Bojtronic/TFG/imagenes/PINOUT.jpeg

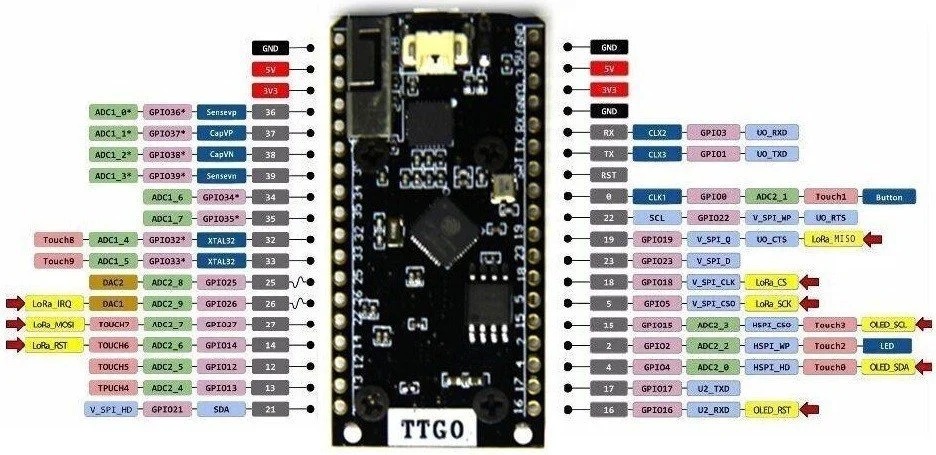
imagenes/PINOUT.jpeg
