Bojtronic/TFG/imagenes/fuego y leña.png

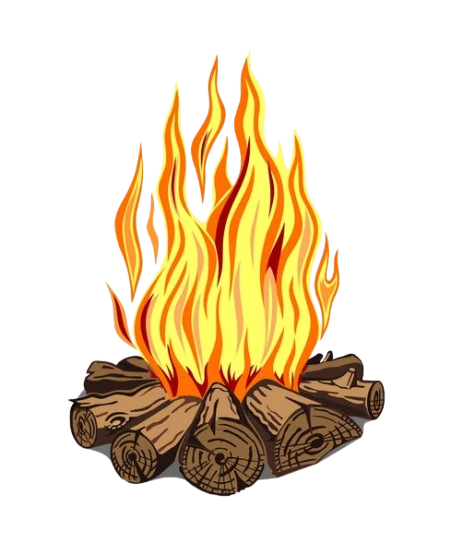
imagenes/fuego y leña.png
