Bojtronic/TFG/imagenes/Aplicacion web.PNG

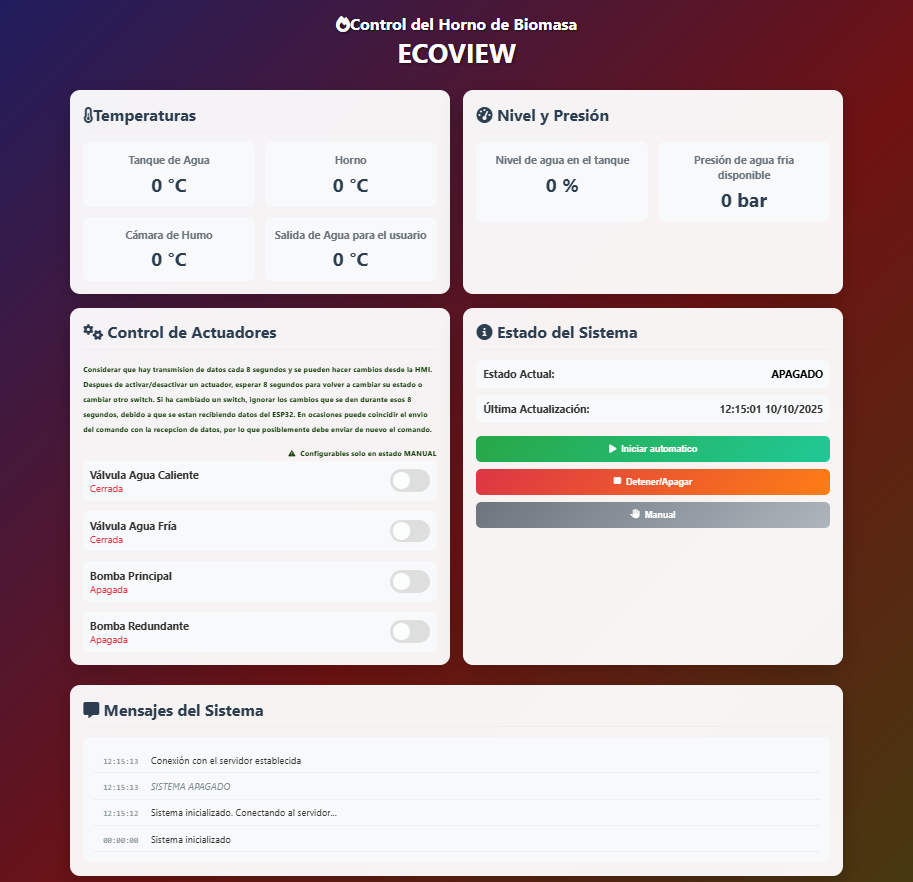
imagenes/Aplicacion web.PNG
