Bojtronic/TFG/imagenes/Bomba de agua.jpg

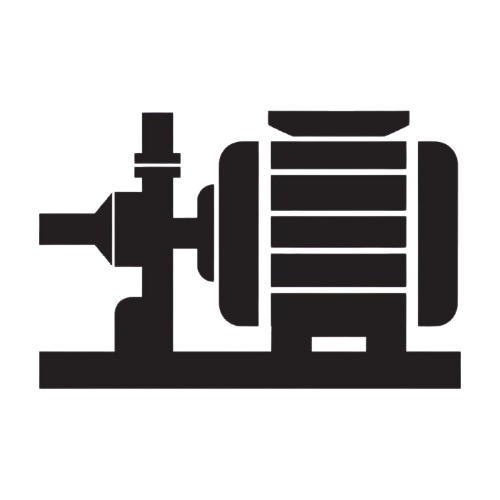
imagenes/Bomba de agua.jpg
