Bojtronic/TFG/imagenes/Canal de señal analogica.PNG

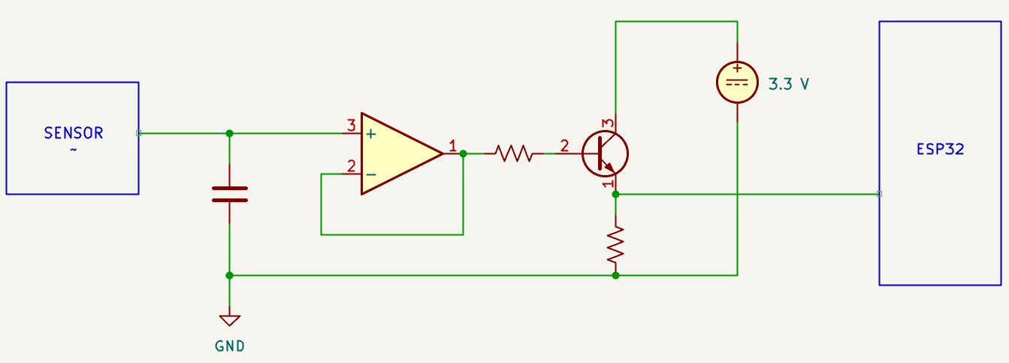
imagenes/Canal de señal analogica.PNG
