Bojtronic/TFG/imagenes/Circuito basico termocupla.PNG

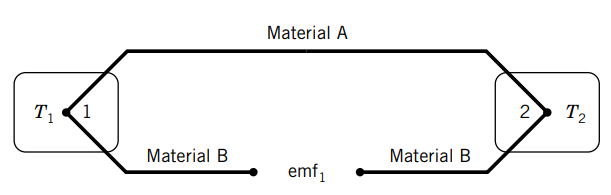
imagenes/Circuito basico termocupla.PNG
