Bojtronic/TFG/imagenes/circulacion de agua.png

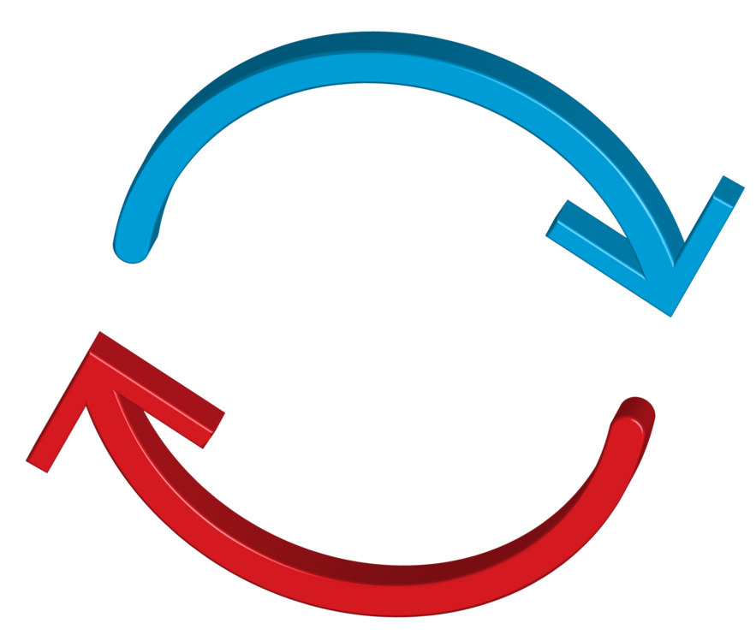
imagenes/circulacion de agua.png
