Bojtronic/TFG/imagenes/Compuerta de chimenea.png

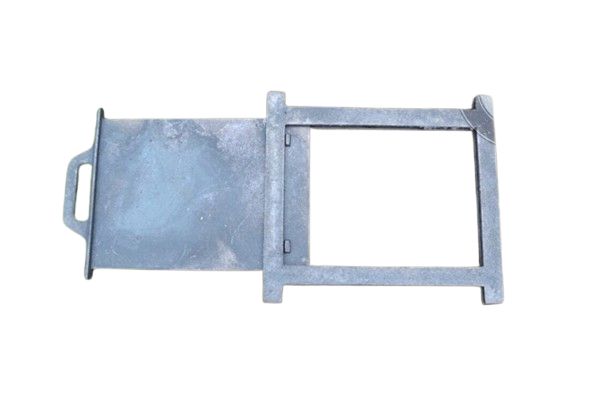
imagenes/Compuerta de chimenea.png
