Bojtronic/TFG/imagenes/Cronograma.PNG

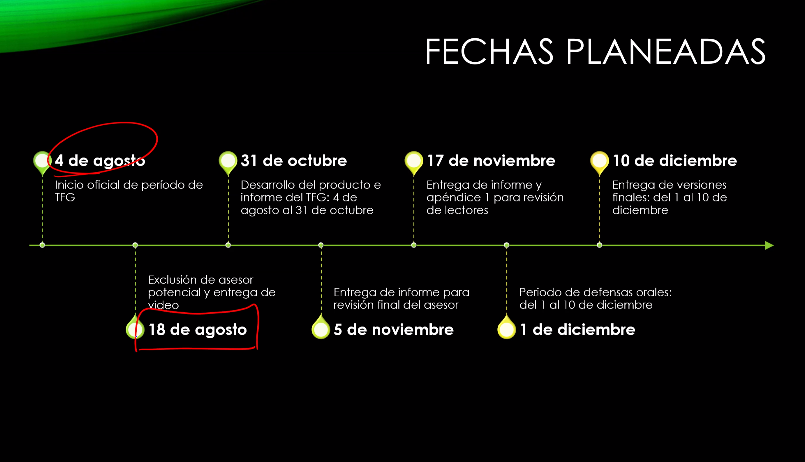
imagenes/Cronograma.PNG
