Bojtronic/TFG/imagenes/Datos importantes.PNG

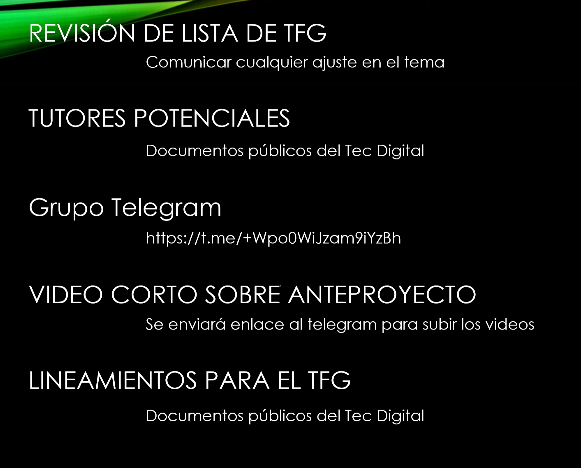
imagenes/Datos importantes.PNG
