Bojtronic/TFG/imagenes/Diagrama del sistema Horno-EcoView organizado.png

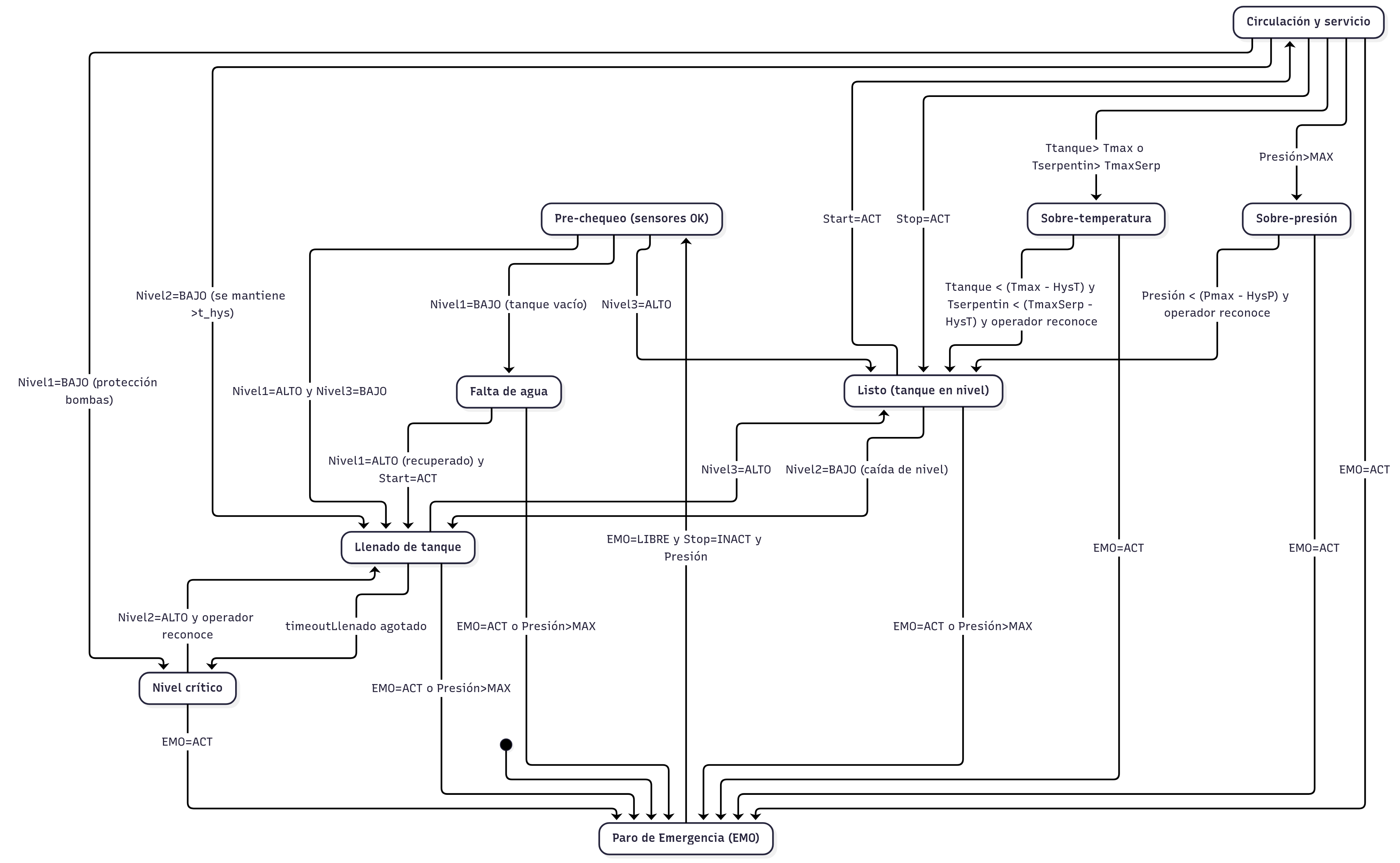
imagenes/Diagrama del sistema Horno-EcoView organizado.png
