Bojtronic/TFG/imagenes/Diagrama del sistema Horno-EcoView.png

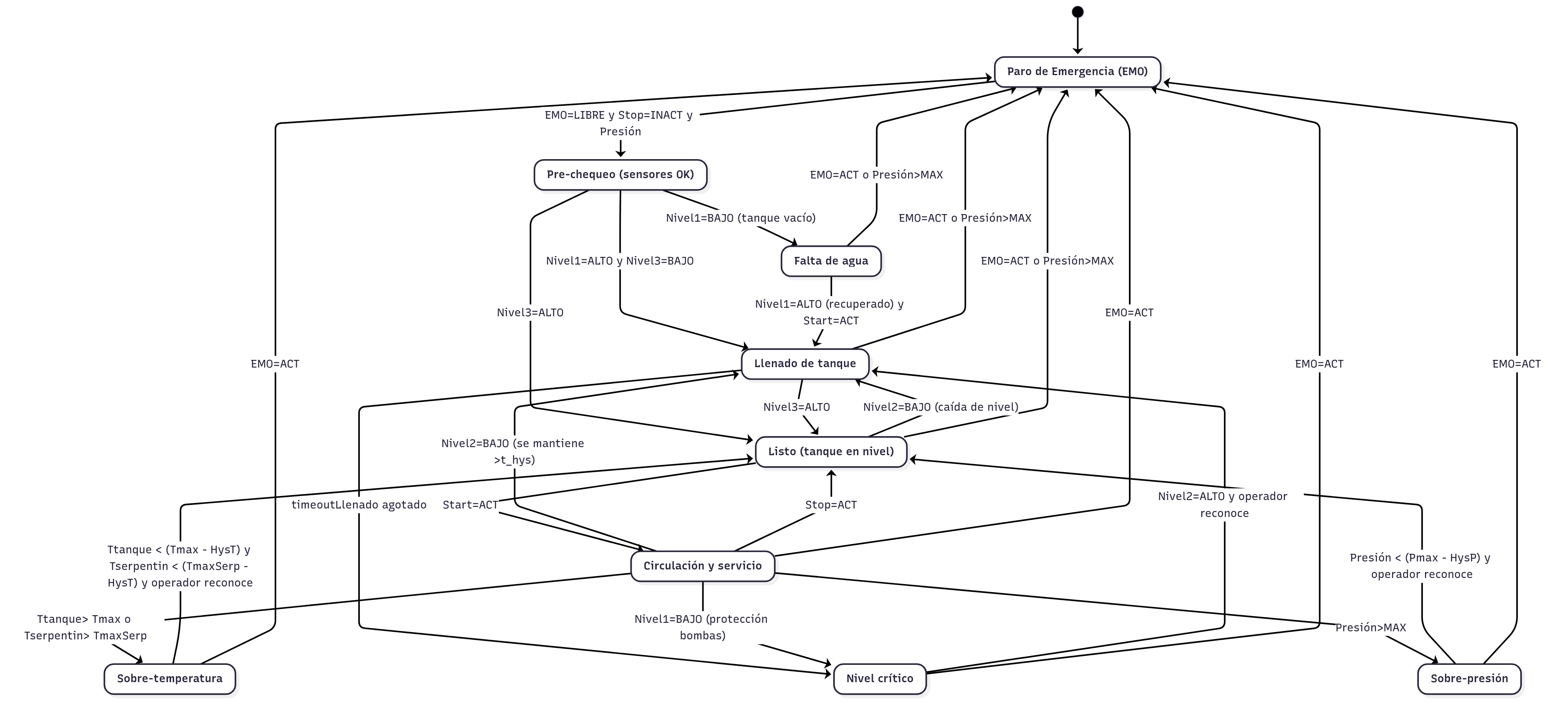
imagenes/Diagrama del sistema Horno-EcoView.png
