Bojtronic/TFG/imagenes/Diagramas-Hardware.png

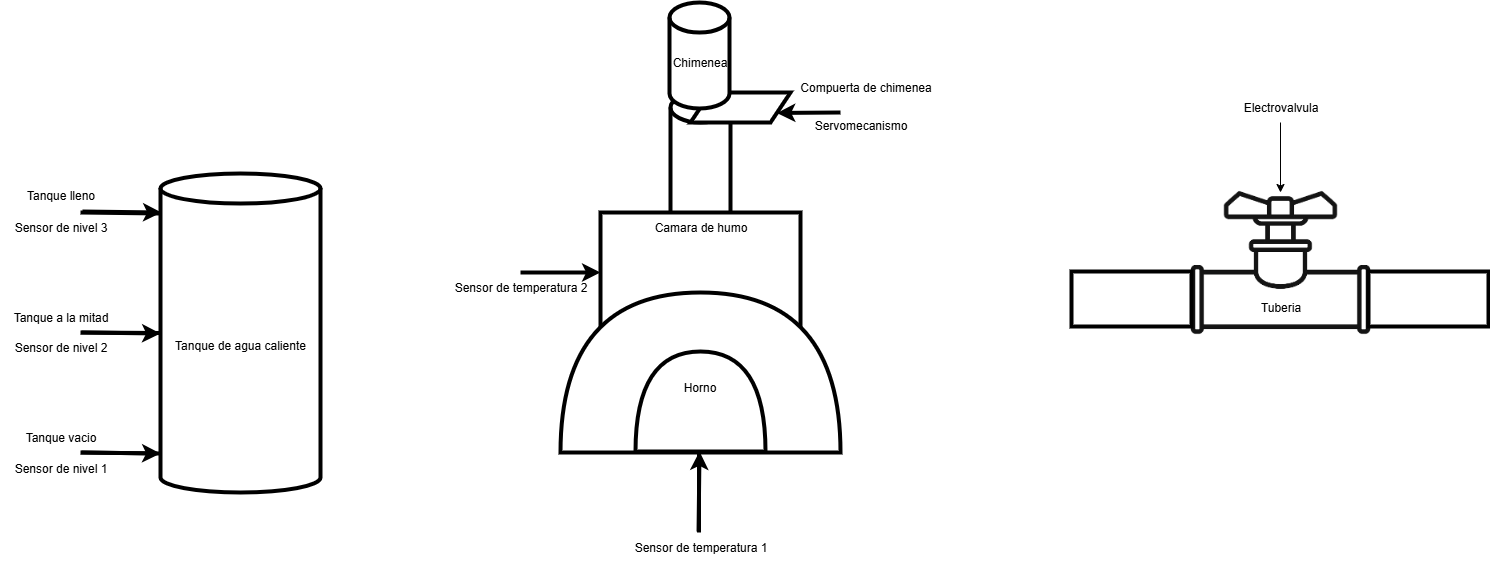
imagenes/Diagramas-Hardware.png
