Bojtronic/TFG/imagenes/Diagramas-Horno.png

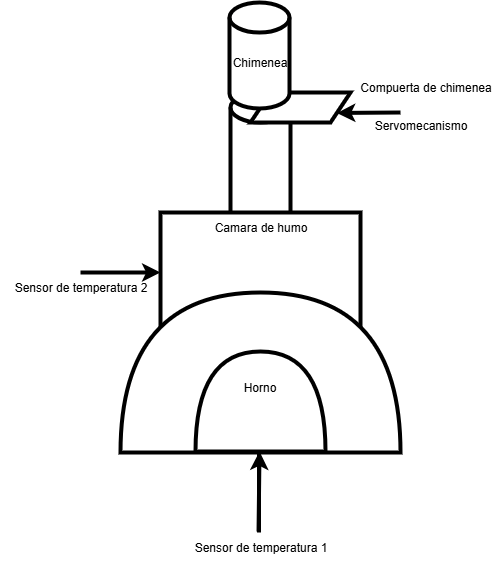
imagenes/Diagramas-Horno.png
