Bojtronic/TFG/imagenes/Diagramas-Tanque de agua.png

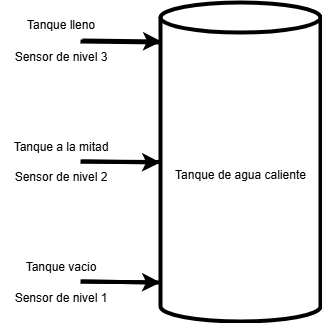
imagenes/Diagramas-Tanque de agua.png
