Bojtronic/TFG/imagenes/Diagramas-Tuberias.png

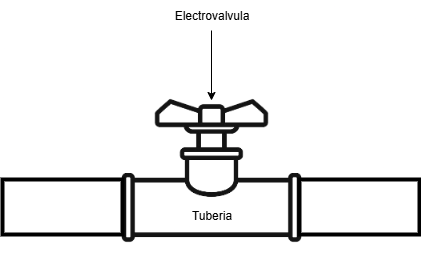
imagenes/Diagramas-Tuberias.png
