Bojtronic/TFG/imagenes/FSM.png

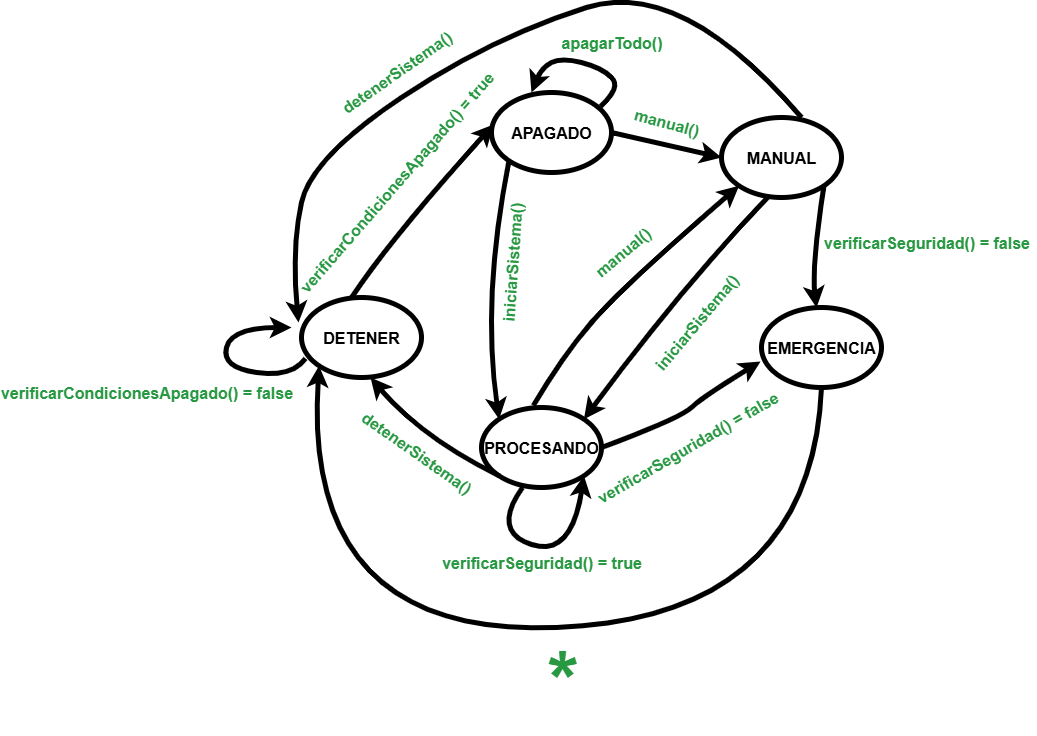
imagenes/FSM.png
