Bojtronic/TFG/imagenes/Humo.png

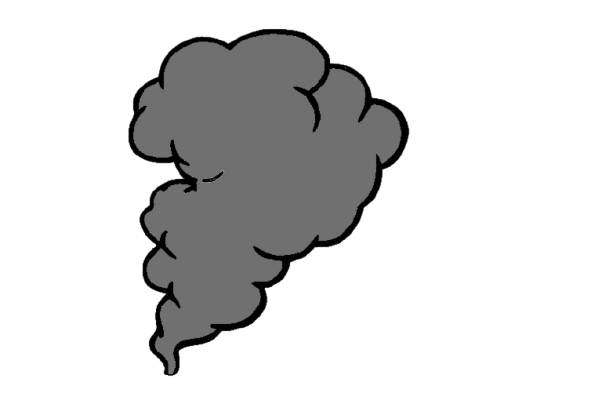
imagenes/Humo.png
