Bojtronic/TFG/imagenes/Informe quincenal.PNG

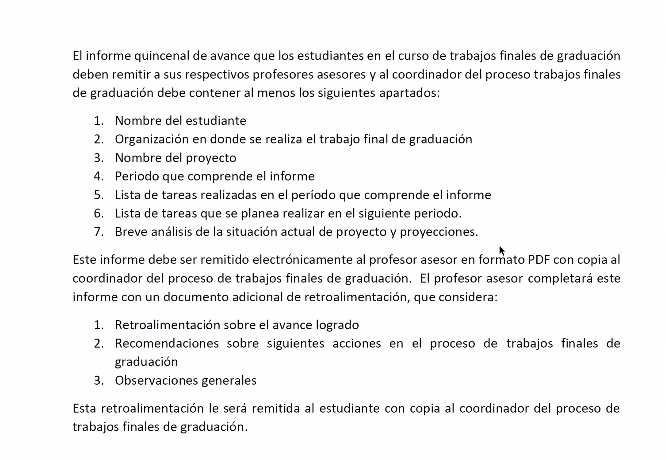
imagenes/Informe quincenal.PNG
