Bojtronic/TFG/imagenes/Interfaz_HMI.PNG

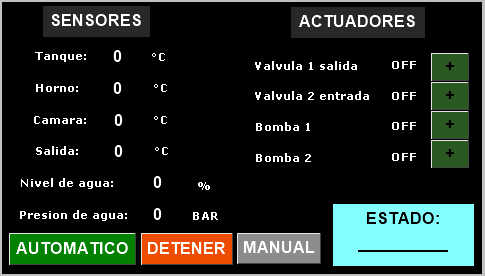
imagenes/Interfaz_HMI.PNG
