Bojtronic/TFG/imagenes/Mapa conceptual.png

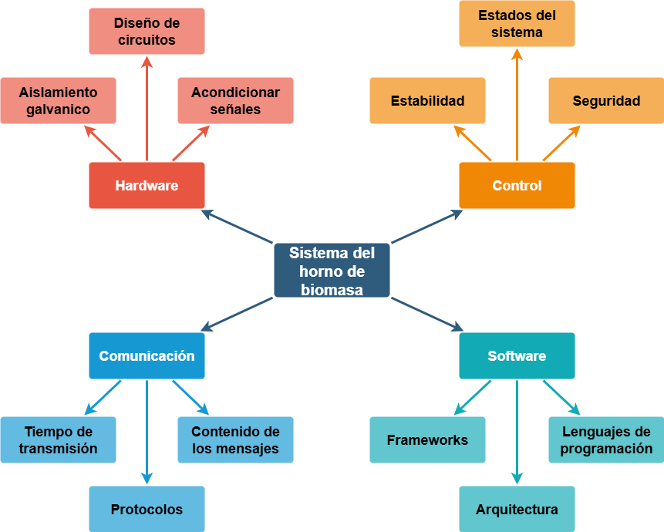
imagenes/Mapa conceptual.png
