Bojtronic/TFG/imagenes/Objetivo general.PNG

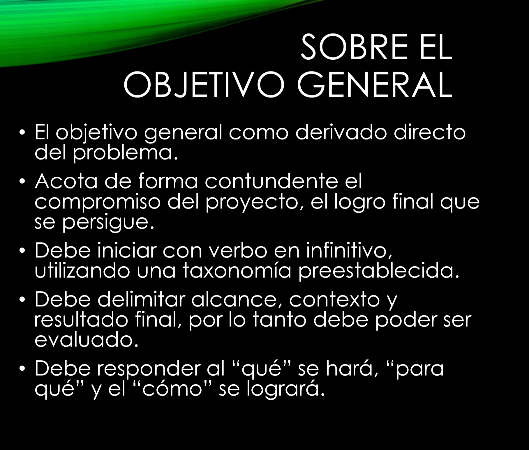
imagenes/Objetivo general.PNG
