Bojtronic/TFG/imagenes/On off.jpg

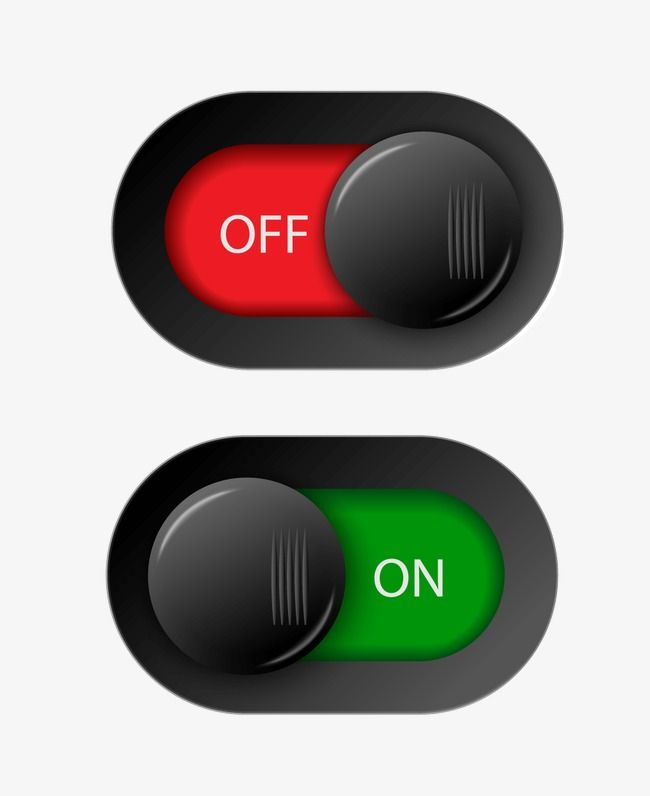
imagenes/On off.jpg
