Bojtronic/TFG/imagenes/Puntos de atencion.PNG

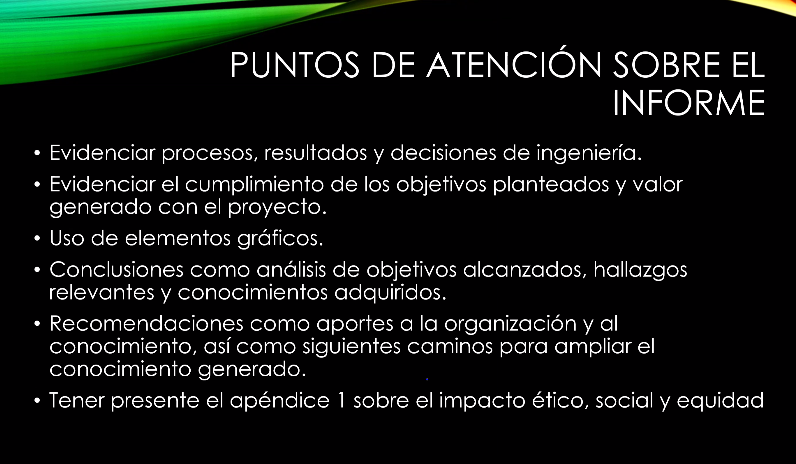
imagenes/Puntos de atencion.PNG
