Bojtronic/TFG/imagenes/Puntos del informe.PNG

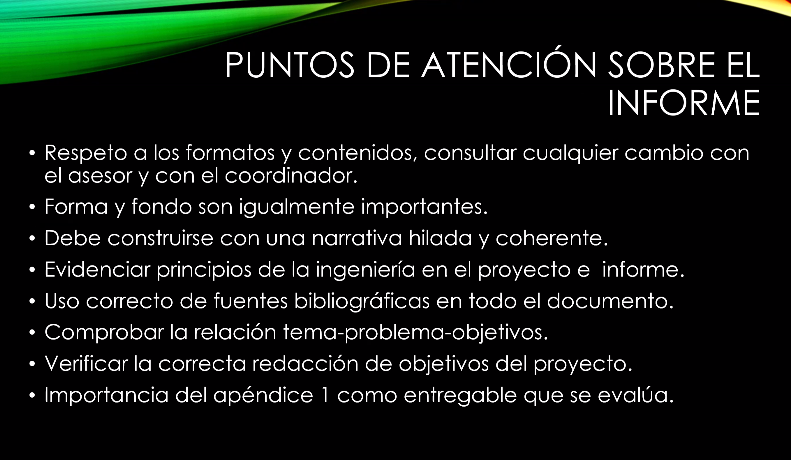
imagenes/Puntos del informe.PNG
