Bojtronic/TFG/imagenes/Sensor de presion.png

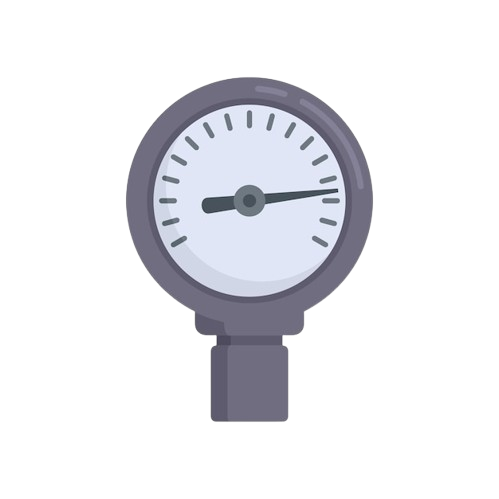
imagenes/Sensor de presion.png
