Bojtronic/TFG/imagenes/sensors data.png

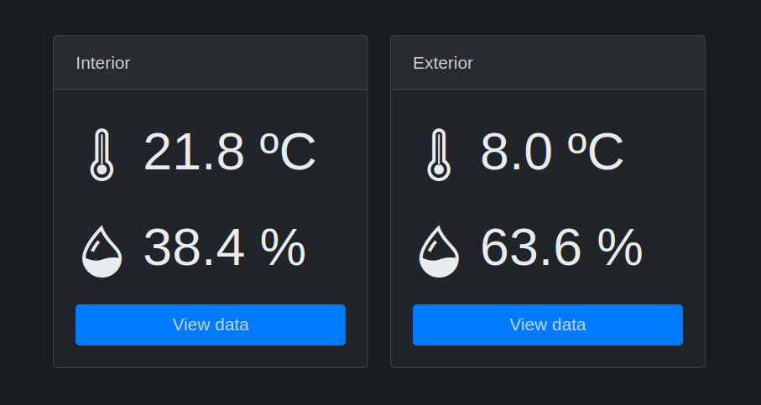
imagenes/sensors data.png
