Bojtronic/TFG/imagenes/Simulacion BJT seguidor emisor.PNG

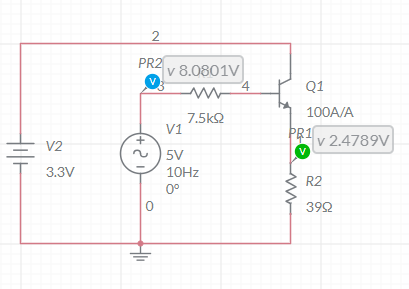
imagenes/Simulacion BJT seguidor emisor.PNG
