Bojtronic/TFG/imagenes/Temperature data.png

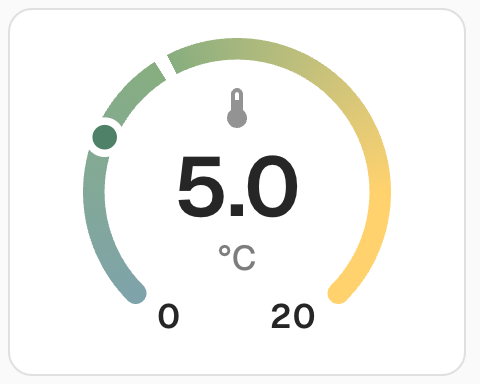
imagenes/Temperature data.png
