Bojtronic/TFG/imagenes/Tuberia rebalse.jpg

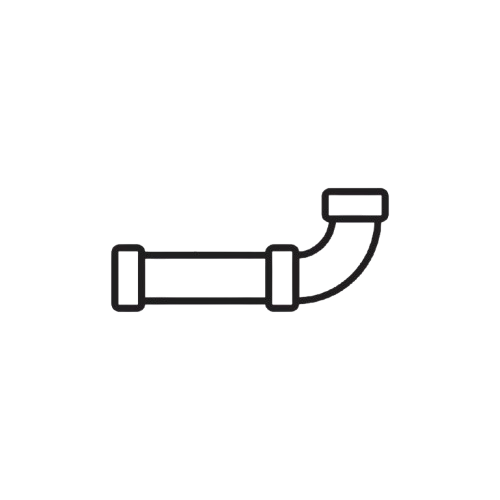
imagenes/Tuberia rebalse.jpg
