Bojtronic/TFG/imagenes/tuberia.png

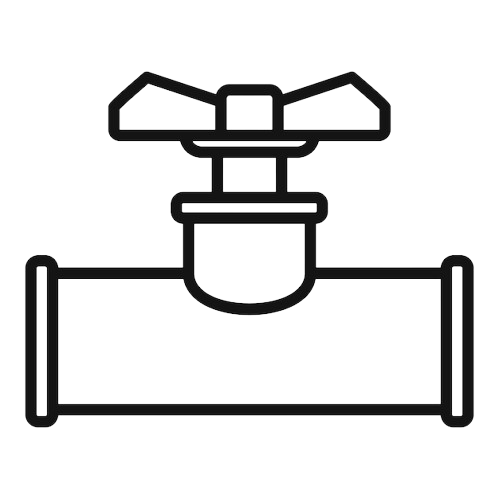
imagenes/tuberia.png
