Bojtronic/TFG/imagenes/Video.PNG

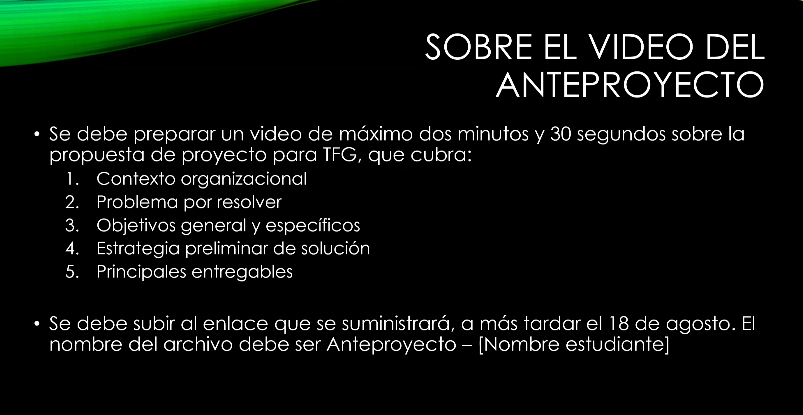
imagenes/Video.PNG
