Bojtronic/TFG/imagenes/Prueba de ingles.PNG

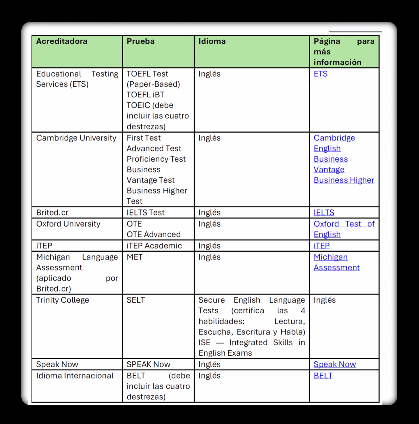
imagenes/Prueba de ingles.PNG
