Bojtronic/TFG/Hardware/PCB_HORNO/PCB_HORNO.pdf

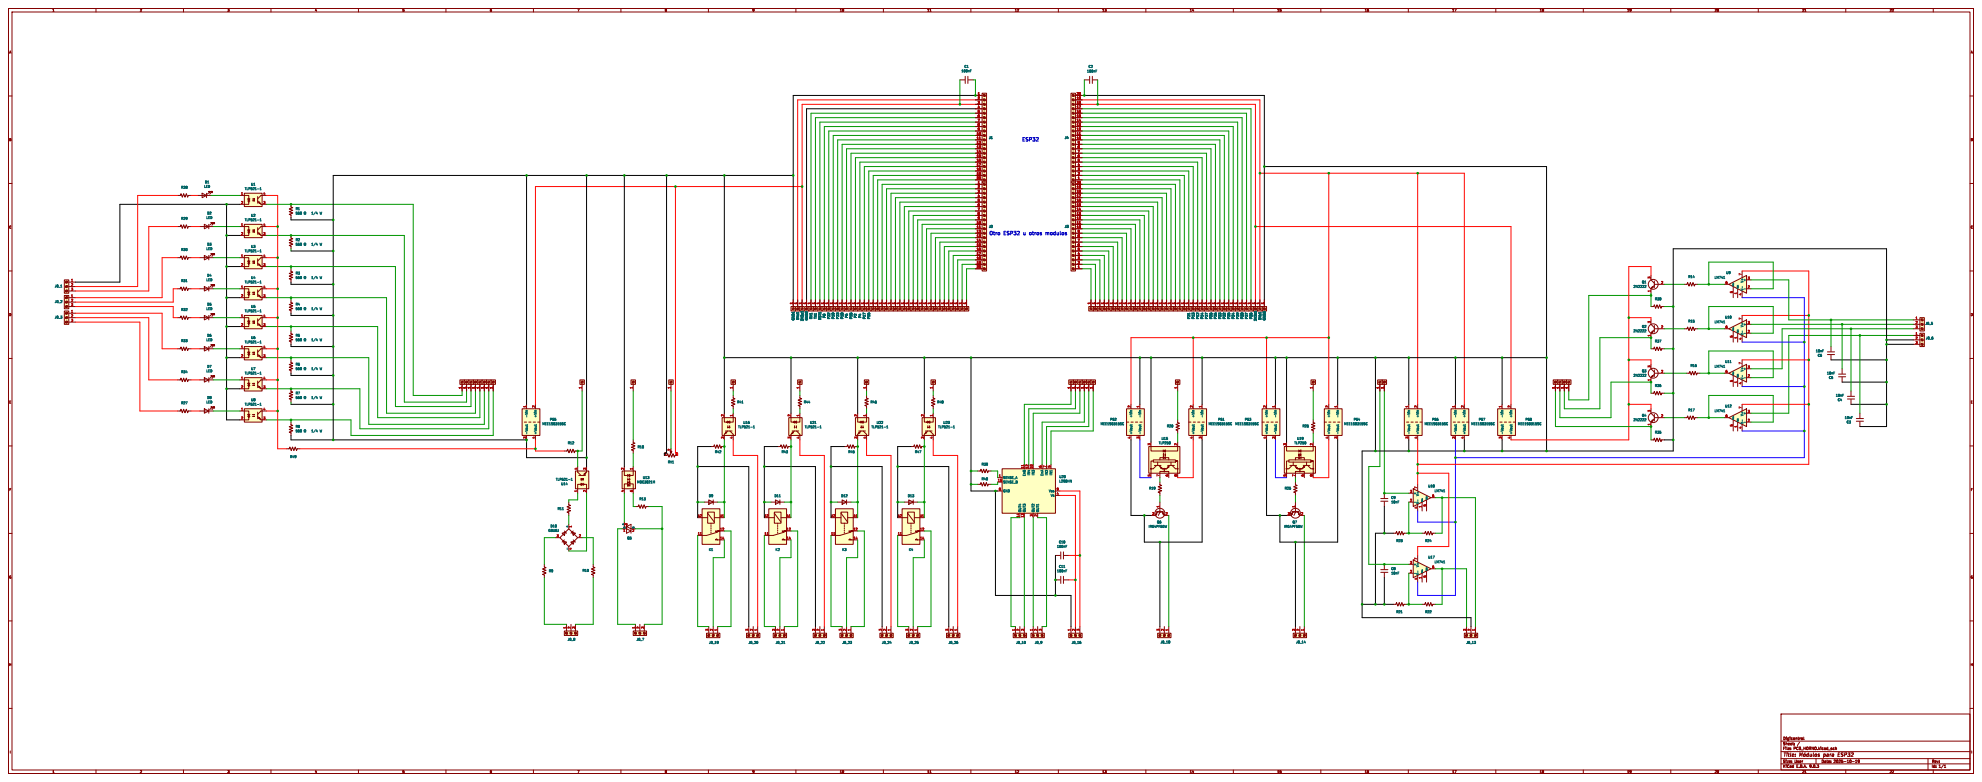
[picture p48: page 1]

Id: 1/1 Title: þÿMódulos para ESP32
