Bojtronic/TFG/Hardware/Analogicas/Interfaz_analogica/Interfaz_analogica.pdf

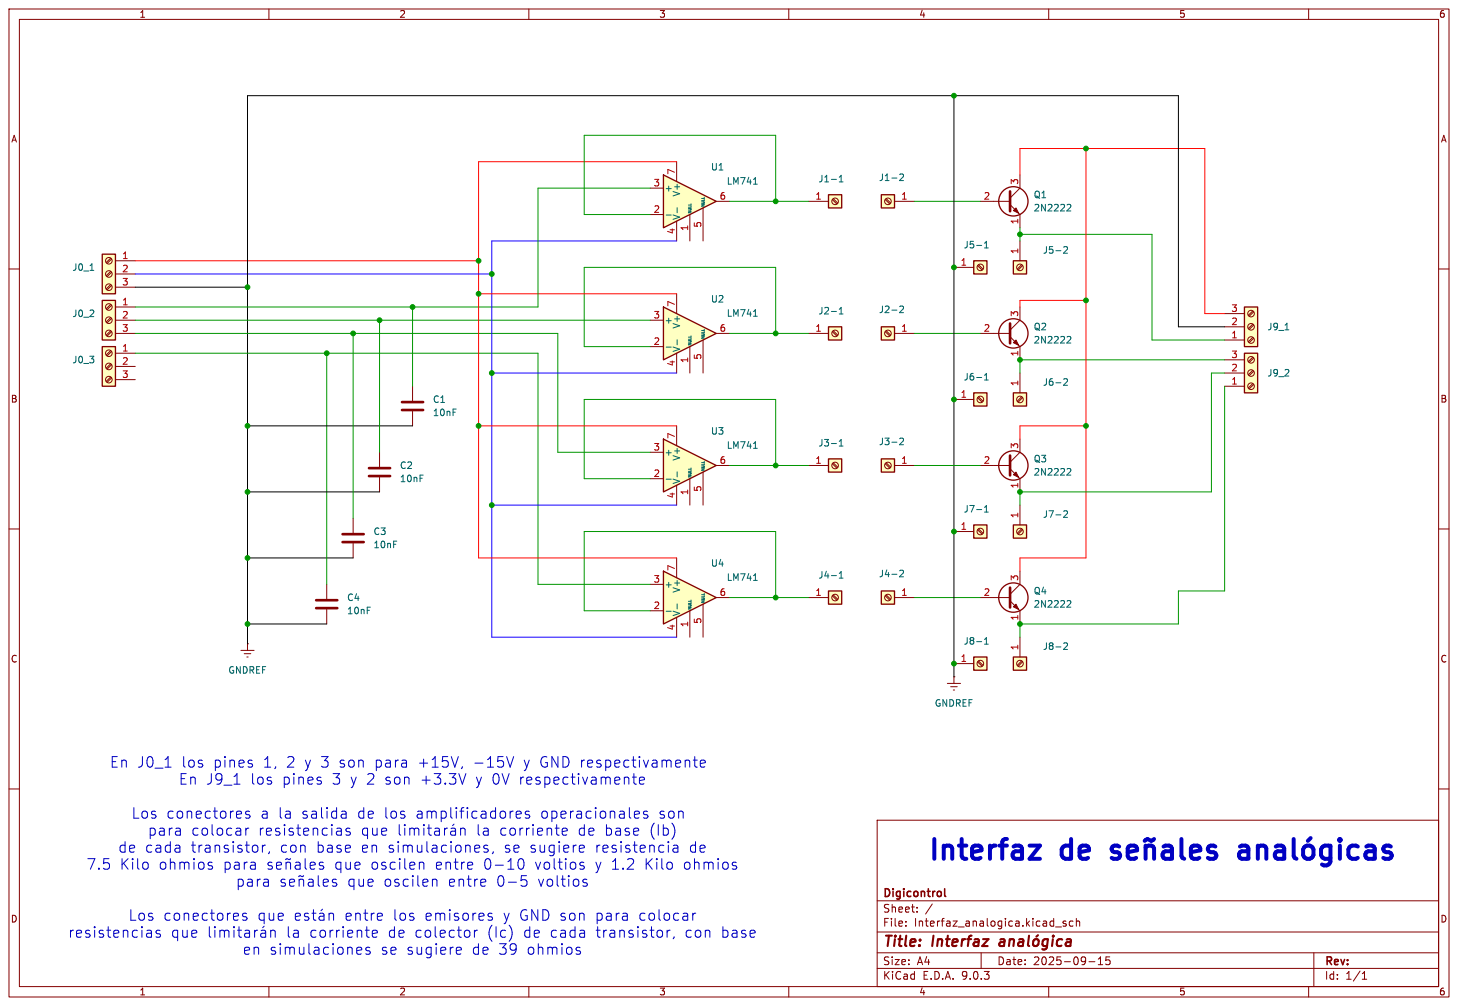
[picture p49: page 1]

Interfaz de þÿseñales þÿanalógicas

para þÿseñales que oscilen entre 0-5 voltios

Id: 1/1 Title: Interfaz þÿanalógica
