Bojtronic/TFG/Hardware/esp32/interfaz_esp32/interfaz_esp32.pdf

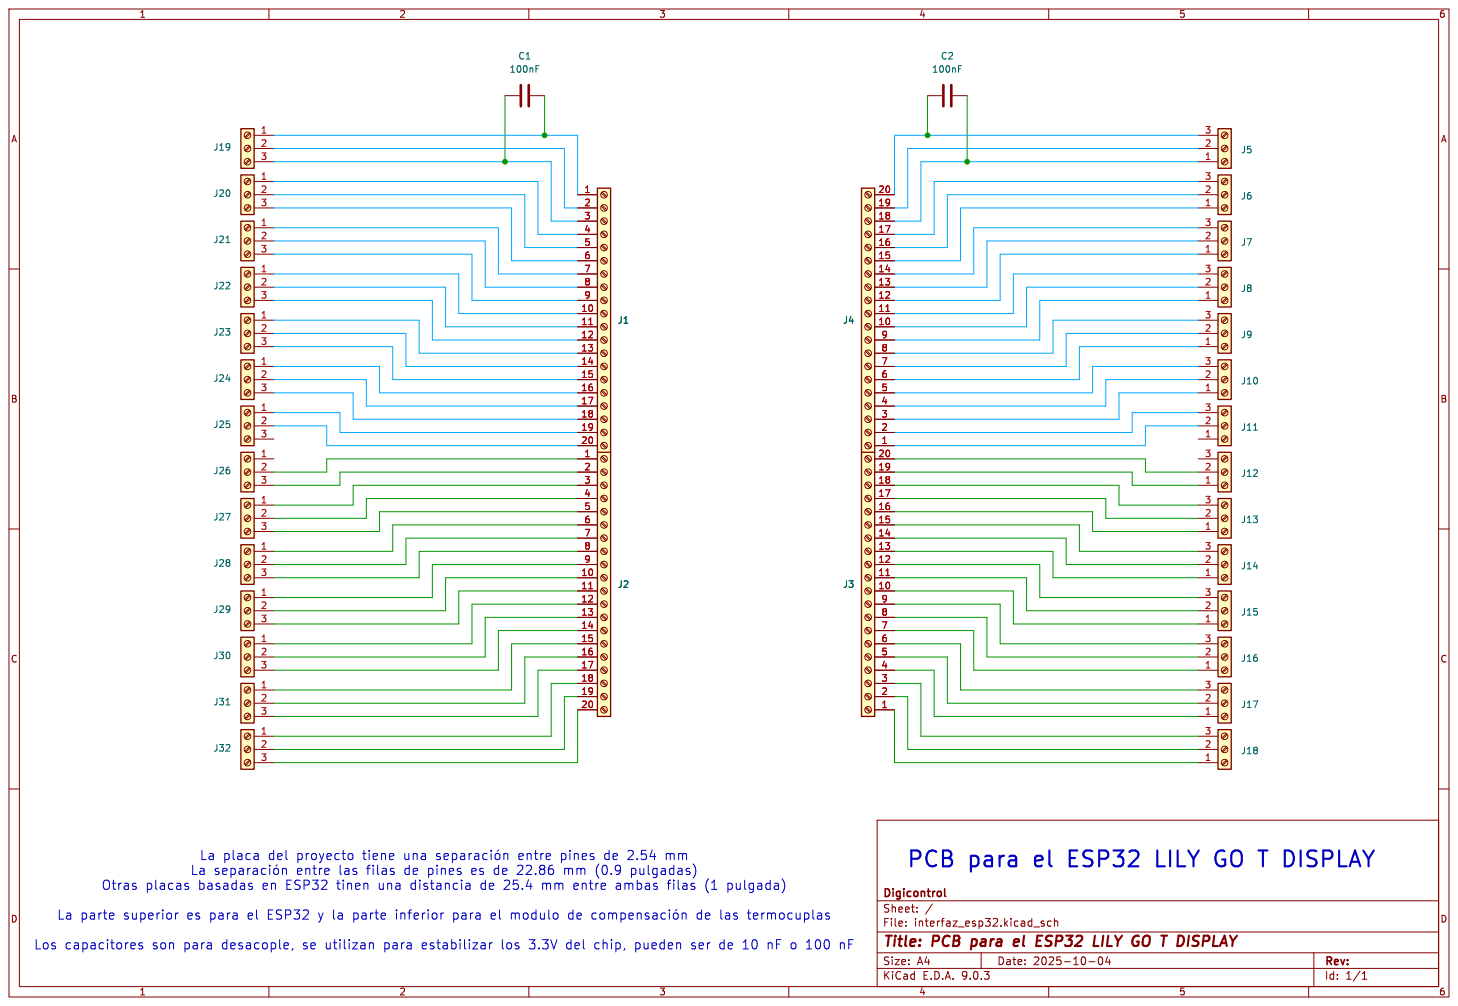
[picture p50: page 1]

La þÿseparación entre las filas de pines es de 22.86 mm (0.9 pulgadas)

Id: 1/1 Title: PCB para el ESP32 LILY GO T DISPLAY
