Bojtronic/TFG/Hardware/Digitales/Interfaz_digital/Interfaz_digital.pdf

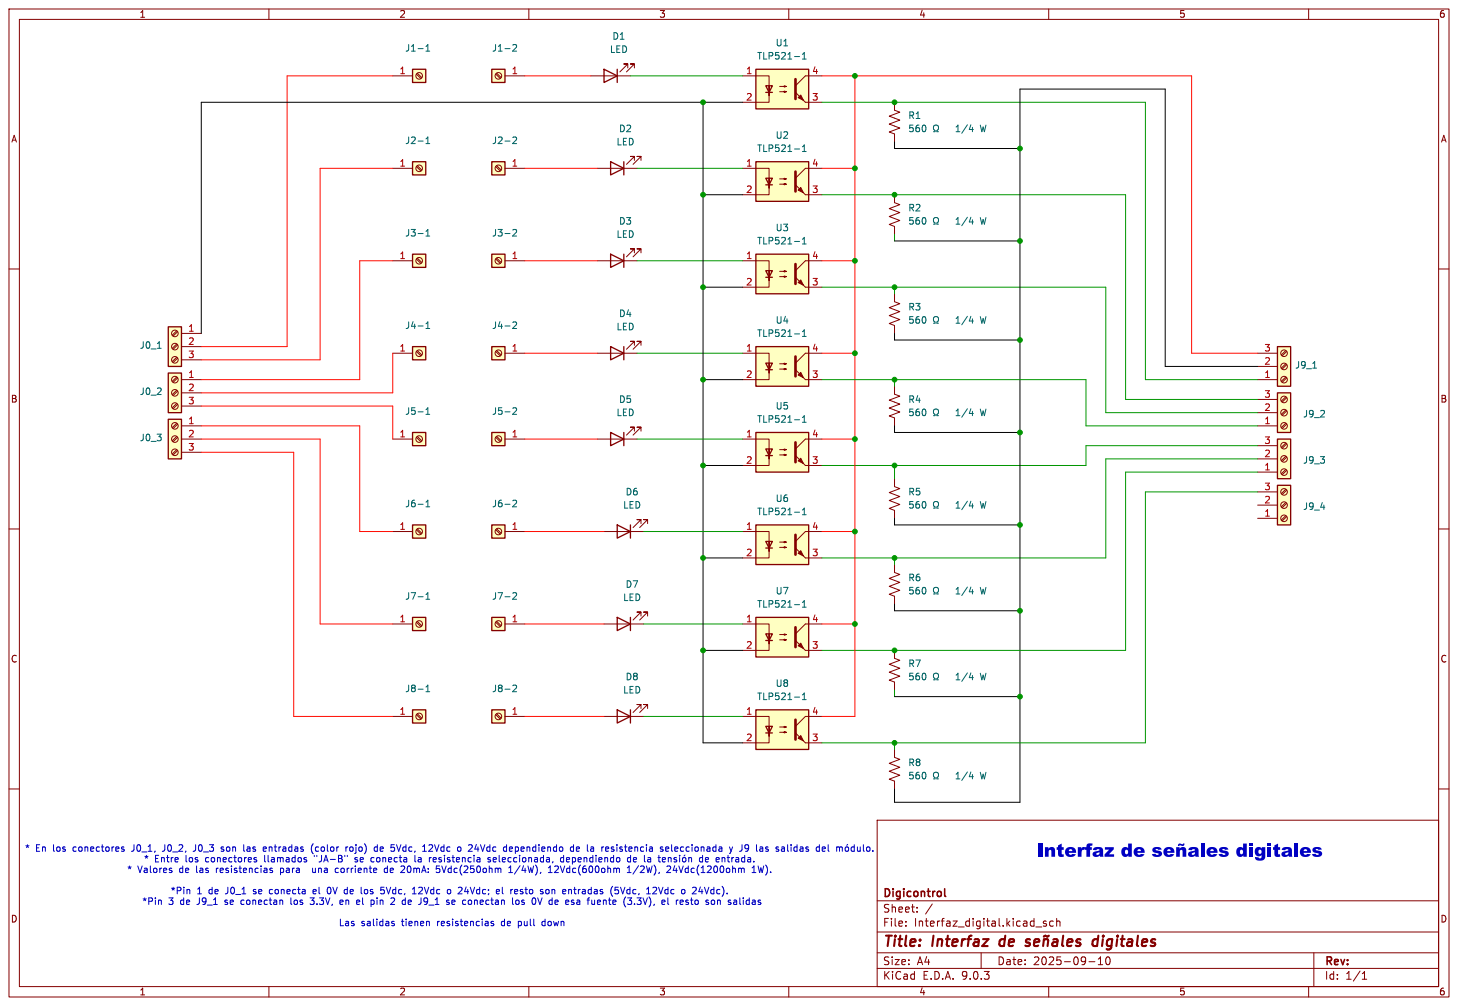
[picture p51: page 1]

Id: 1/1 Title: Interfaz de þÿseñales digitales
