Bojtronic/TFG/Hardware/PCB_HORNO/PCB_HORNO.kicad_pcb

## KiCad design Hardware/PCB_HORNO/PCB_HORNO.kicad_pcb (2025-10-22)

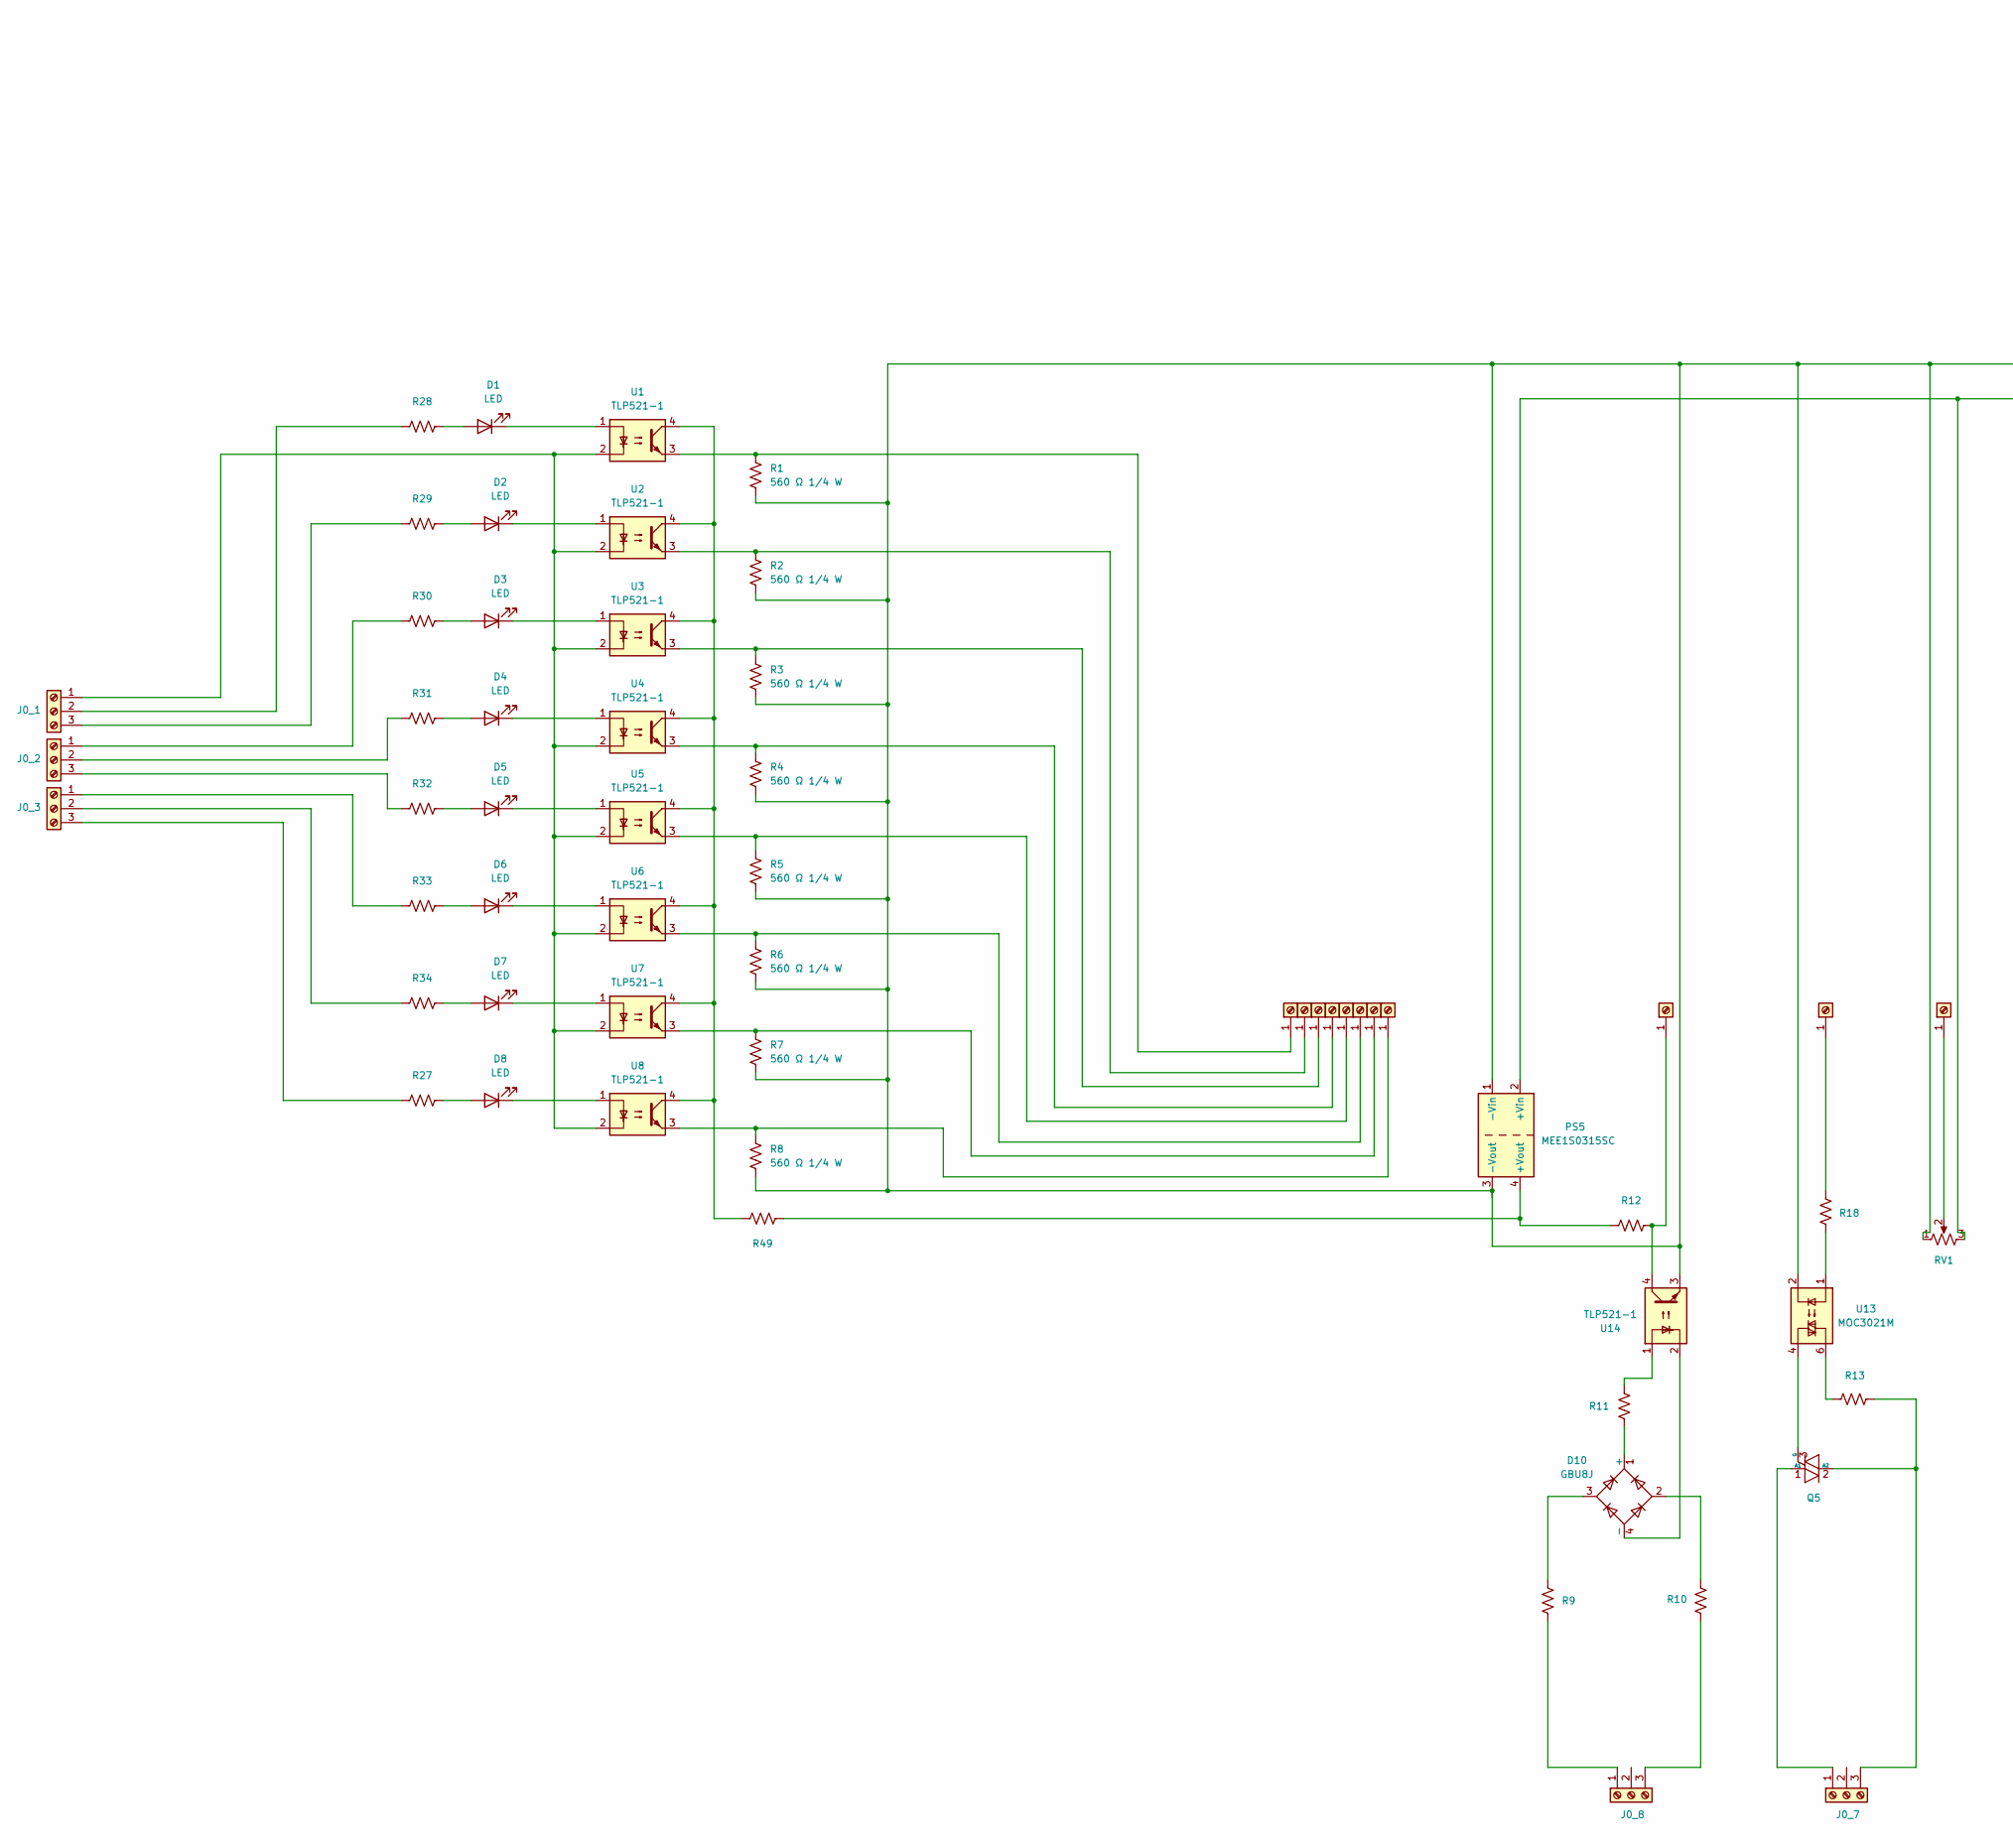
[picture p52: schematic PCB_HORNO.kicad_sch, Módulos para ESP32, part in row 1, column 1]

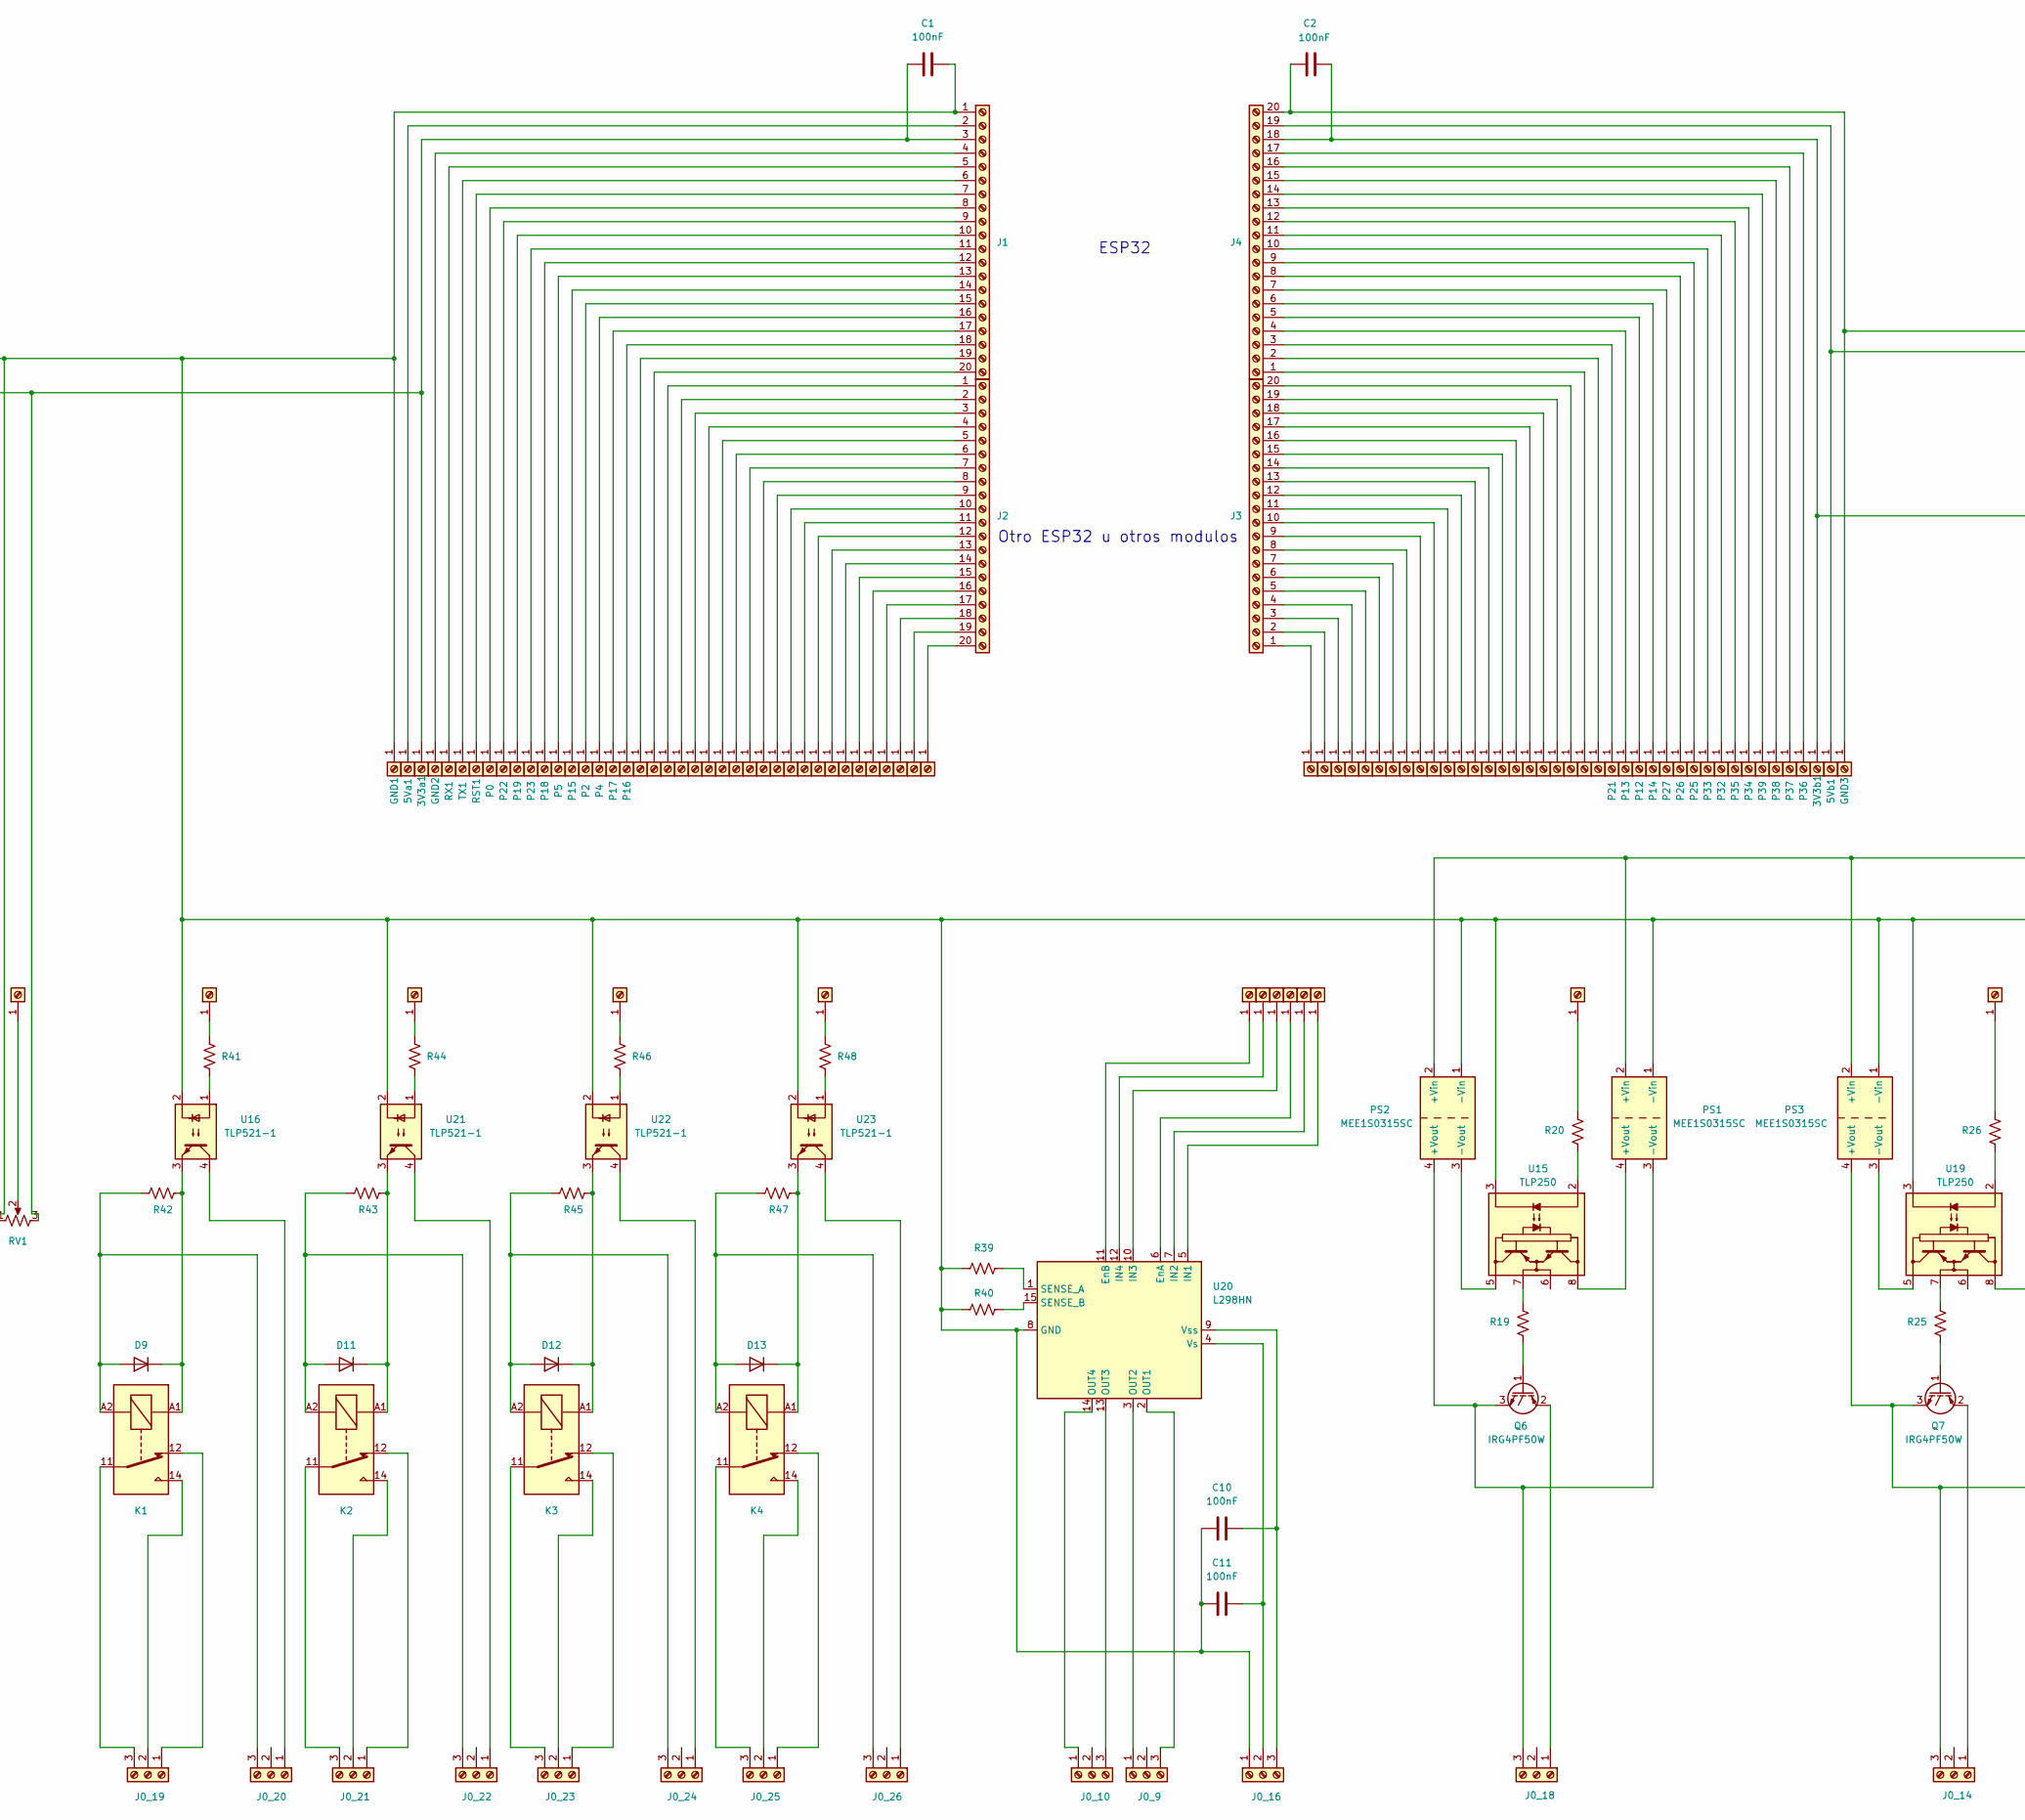
[picture p53: schematic PCB_HORNO.kicad_sch, Módulos para ESP32, part in row 1, column 2]

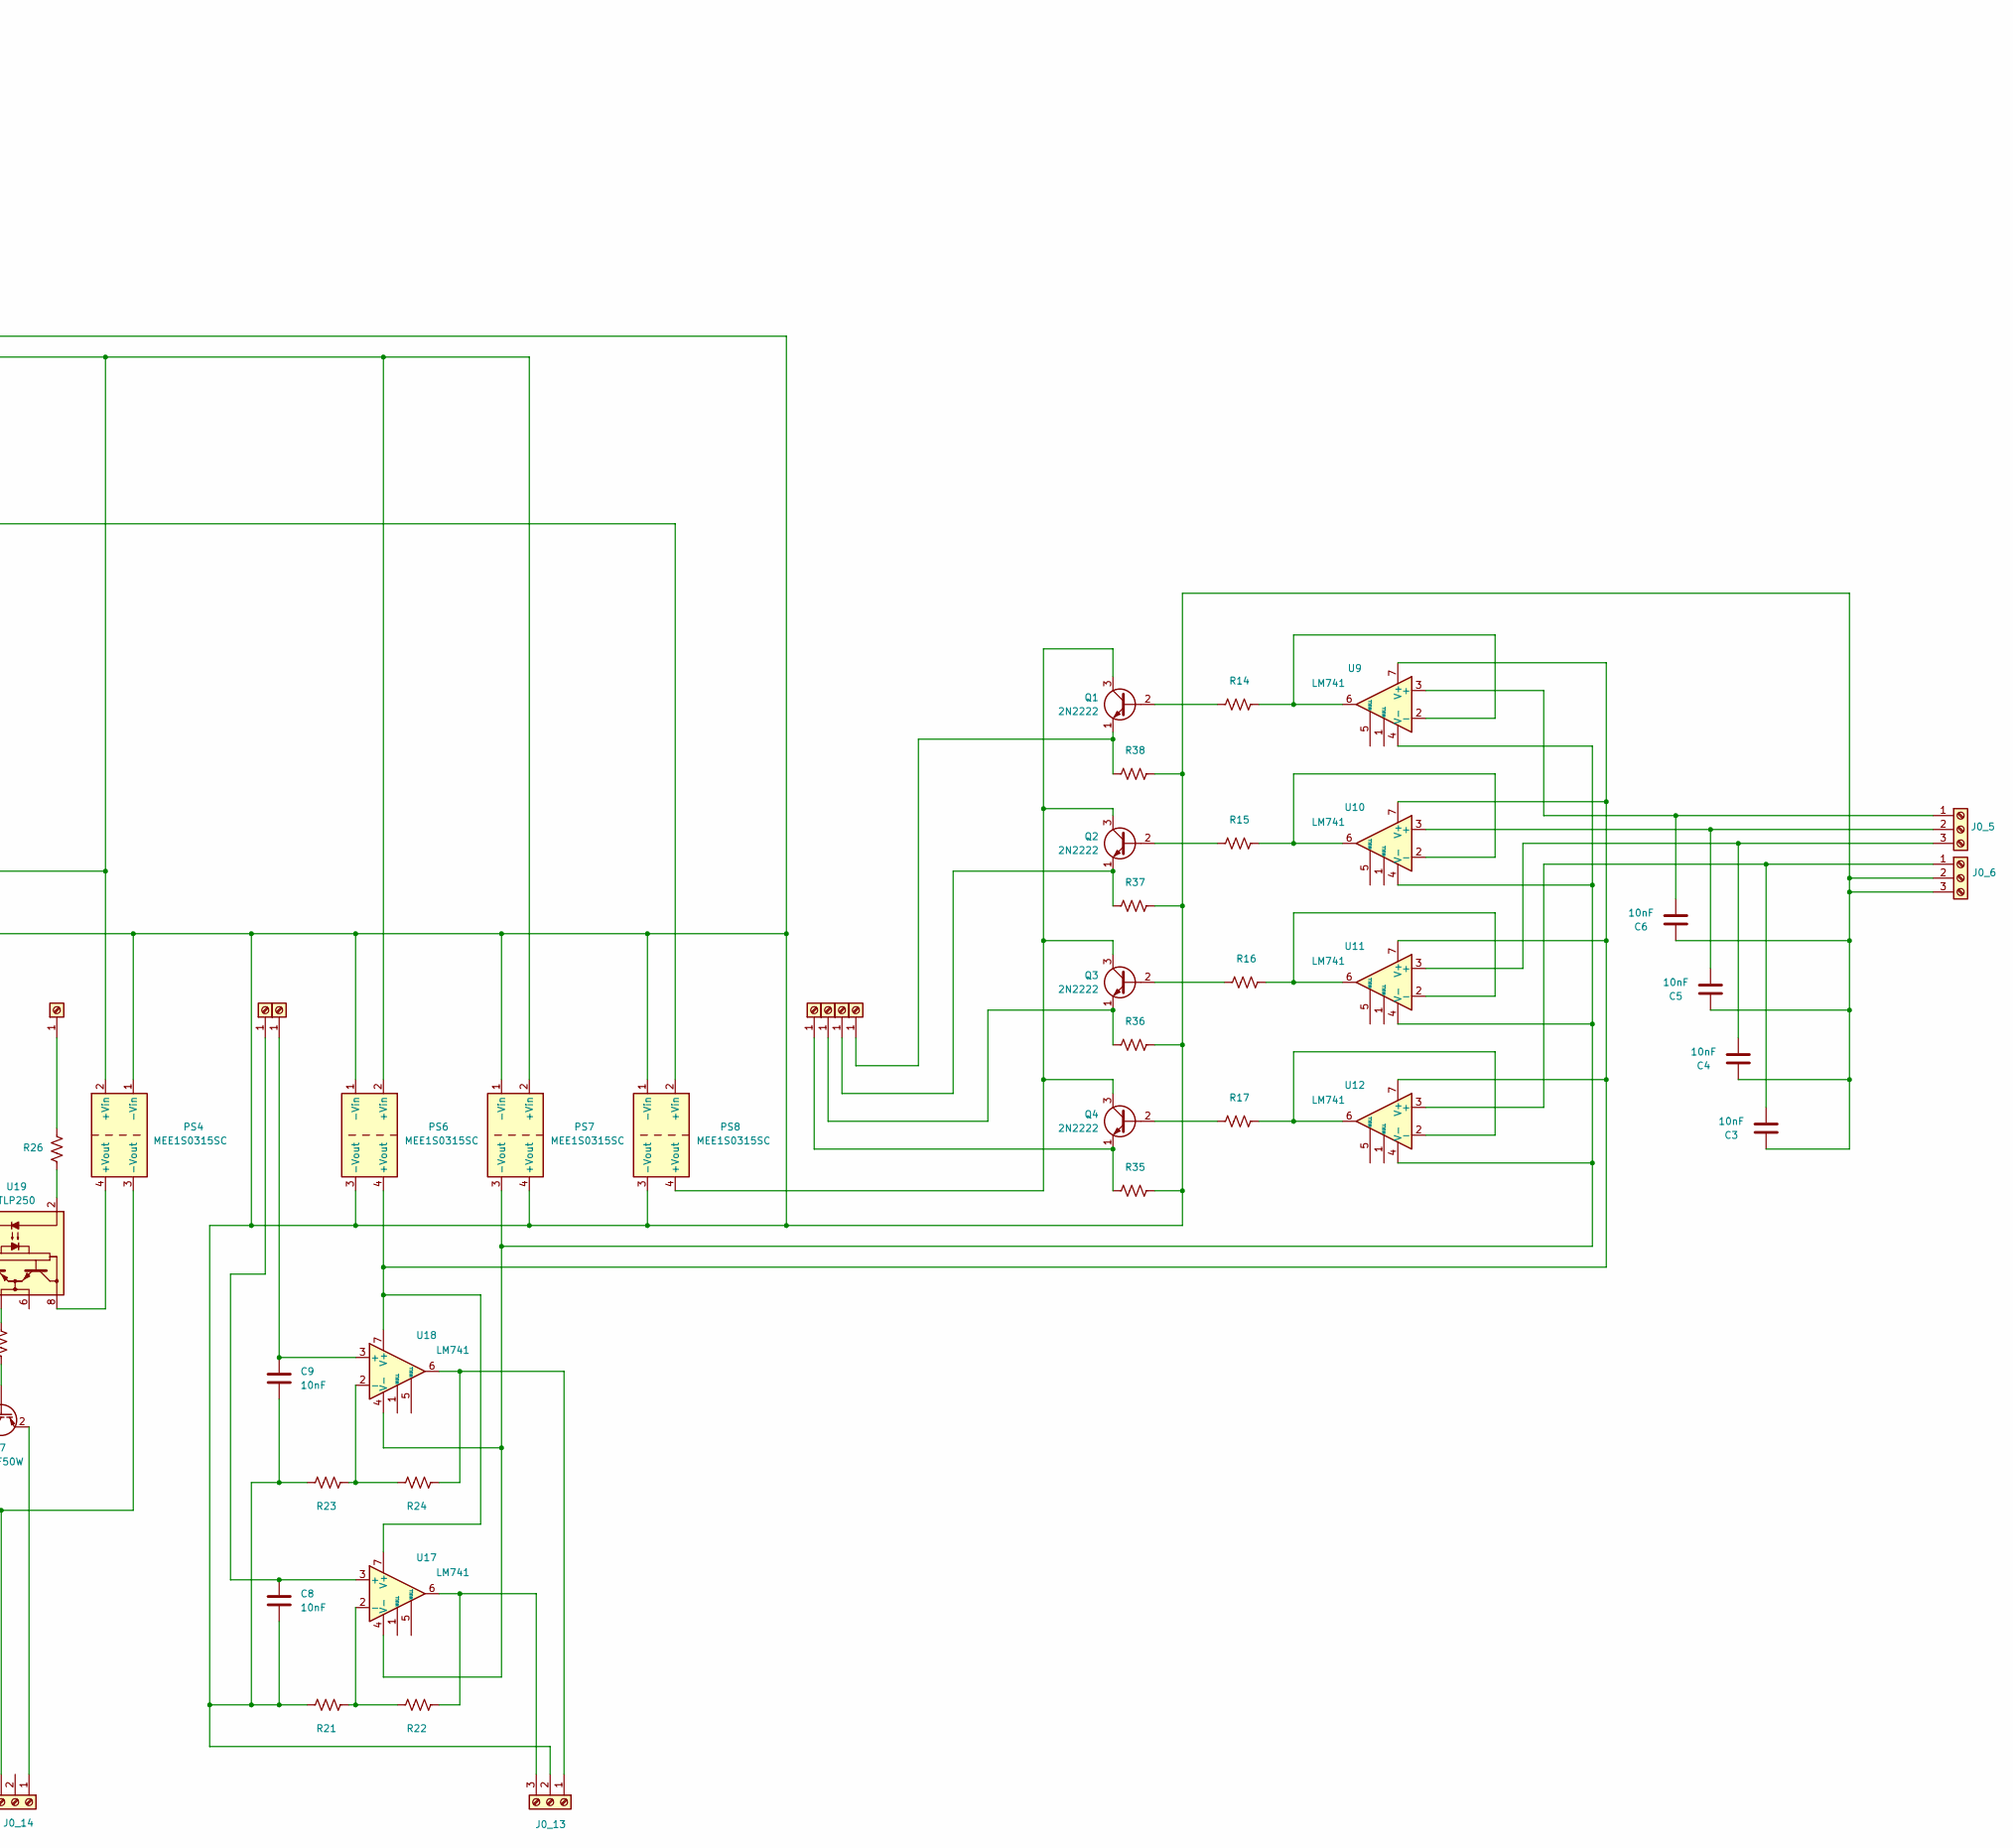
[picture p54: schematic PCB_HORNO.kicad_sch, Módulos para ESP32, part in row 1, column 3]

Parts:
3V3a1, 3V3b1, 5Va1, 5Vb1: SolderWire-0.75sqmm_1x01_D1.25mm_OD2.3mm
C1, C2, C10, C11: 100nF; C_Disc_D5.1mm_W3.2mm_P5.00mm
C3, C4, C5, C6, C8, C9: 10nF; C_Disc_D5.1mm_W3.2mm_P5.00mm
D1, D2, D3, D4, D5, D6, D7, D8: LED; LED_D4.0mm
D9, D11, D12, D13: 1N4007; D_DO-41_SOD81_P10.16mm_Horizontal
D10: GBU8J; Diode_Bridge_Vishay_GBU
GND1, GND2, GND3: SolderWire-0.75sqmm_1x01_D1.25mm_OD2.3mm
J0_1, J0_2, J0_3, J0_5, J0_6, J0_7, J0_8, J0_9, J0_10, J0_13, J0_14, J0_16, J0_18, J0_19, J0_20, J0_21, J0_22, J0_23, J0_24, J0_25, J0_26: Screw_Terminal_01x03; TerminalBlock_Phoenix_PT-1,5-3-3.5-H_1x03_P3.50mm_Horizontal
J1, J2, J3, J4: Screw_Terminal_01x20; PinHeader_1x20_P2.54mm_Vertical
K1, K2, K3, K4: Fujitsu_FTR-LYCA005x; Relay_SPDT_Fujitsu_FTR-LYCA005x_FormC_Vertical
P0, P2, P4, P5, P12, P13, P14, P15, P16, P17, P18, P19, P21, P22, P23, P25, P26, P27, P32, P33, P34, P35, P36, P37, P38, P39: SolderWire-0.75sqmm_1x01_D1.25mm_OD2.3mm
PS1, PS2, PS3, PS4, PS5, PS6, PS7, PS8: MEE1S0315SC; Converter_DCDC_Murata_MEE1SxxxxSC_THT
PX1, PX2, PX3, PX4, PX5, PX6, PX7, PX8, PX9, PX10, PX11, PX12, PX13, PX14, PX15, PX16, PX17, PX18, PX19, PX20, PX21, PX22, PX23, PX24, PX25, PX26, PX27, PX28, PX29, PX30, PX31, PX32, PX33, PX34, PX35, PX36, PX37, PX38, PX39, PX40, PX41, PX42, PX43, PX44, PX45, PX46, PX47, PX48, PX49, PX50, PX51, PX52, PX53, PX54, PX55, PX57, PX59, PX62, PX63, PX66, PX67, PX69, PX72, PX80, PX111, PX112, PX113, PX118, PX119, PX121, PX122, PX123, PX124: SolderWire-0.75sqmm_1x01_D1.25mm_OD2.3mm
Q1, Q2, Q3, Q4: 2N2222; TO-92
Q5: BTA16-800B; TO-220-3_Vertical
Q6, Q7: IRG4PF50W; TO-264-3_Vertical
R1, R2, R3, R4, R5, R6, R7, R8: 560 Ω 1/4 W; R_Axial_DIN0207_L6.3mm_D2.5mm_P10.16mm_Horizontal
R9, R10, R11: R_US; R_Axial_DIN0411_L9.9mm_D3.6mm_P25.40mm_Horizontal
R12, R14, R15, R16, R17, R18, R19, R20, R21, R22, R23, R24, R25, R26, R35, R36, R37, R38, R41, R44, R46, R48, R49: R_US; R_Axial_DIN0207_L6.3mm_D2.5mm_P10.16mm_Horizontal
R13, R27, R28, R29, R30, R31, R32, R33, R34, R39, R40, R42, R43, R45, R47: R_US; R_Axial_DIN0309_L9.0mm_D3.2mm_P15.24mm_Horizontal
RST1: SolderWire-0.75sqmm_1x01_D1.25mm_OD2.3mm
RV1: R_Potentiometer_US; Potentiometer_Bourns_3266W_Vertical
RX1: SolderWire-0.75sqmm_1x01_D1.25mm_OD2.3mm
TX1: SolderWire-0.75sqmm_1x01_D1.25mm_OD2.3mm
U1, U2, U3, U4, U5, U6, U7, U8, U14, U16, U21, U22, U23: TLP521-1; DIP-4_W7.62mm
U9, U10, U11, U12, U17, U18: LM741; LM471_TH
U13: MOC3021M; DIP-6_W7.62mm
U15, U19: TLP250; DIP-8_W7.62mm
U20: L298HN; TO-220-15_P2.54x2.54mm_StaggerOdd_Lead5.84mm_TabDown

Connections:
unnamed: 3V3a1.1, C1.1, J1.3, PS5.2 (+Vin), RV1.3
unnamed: 3V3b1.1, C2.1, J4.18, PS8.2 (+Vin)
unnamed: 5Va1.1, J1.2
unnamed: 5Vb1.1, J4.19, PS1.2 (+Vin), PS2.2 (+Vin), PS3.2 (+Vin), PS4.2 (+Vin), PS6.2 (+Vin), PS7.2 (+Vin)
unnamed: D1.2 (A), R28.2
unnamed: D1.1 (K), U1.1
unnamed: D2.2 (A), R29.2
unnamed: D2.1 (K), U2.1
unnamed: D3.2 (A), R30.2
unnamed: D3.1 (K), U3.1
unnamed: D4.2 (A), R31.2
unnamed: D4.1 (K), U4.1
unnamed: D5.2 (A), R32.2
unnamed: D5.1 (K), U5.1
unnamed: D6.2 (A), R33.2
unnamed: D6.1 (K), U6.1
unnamed: D7.2 (A), R34.2
unnamed: D7.1 (K), U7.1
unnamed: D8.2 (A), R27.2
unnamed: D8.1 (K), U8.1
unnamed: D9.2 (A), J0_20.3, K1.A2, R42.1
unnamed: D9.1 (K), K1.A1, R42.2, U16.3
unnamed: D10.1 (+), R11.1
unnamed: D10.4 (-), U14.2
unnamed: D10.2, R10.2
unnamed: D10.3, R9.2
unnamed: D11.2 (A), J0_22.3, K2.A2, R43.1
unnamed: D11.1 (K), K2.A1, R43.2, U21.3
unnamed: D12.2 (A), J0_24.3, K3.A2, R45.1
unnamed: D12.1 (K), K3.A1, R45.2, U22.3
unnamed: D13.2 (A), J0_26.3, K4.A2, R47.1
unnamed: D13.1 (K), K4.A1, R47.2, U23.3
unnamed: C1.2, C2.2, C3.2, C4.2, C5.2, C6.2, C8.2, C9.2, C10.1, C11.1, GND1.1, GND3.1, J0_6.2, J0_6.3, J0_13.2, J0_16.1, J1.1, J4.20, PS1.1 (-Vin), PS2.1 (-Vin), PS3.1 (-Vin), PS4.1 (-Vin), PS5.1 (-Vin), PS5.3 (-Vout), PS6.1 (-Vin), PS6.3 (-Vout), PS7.1 (-Vin), PS7.4 (+Vout), PS8.1 (-Vin), PS8.3 (-Vout), R1.2, R2.2, R3.2, R4.2, R5.2, R6.2, R7.2, R8.2, R21.2, R23.2, R35.2, R36.2, R37.2, R38.2, R39.1, R40.1, RV1.1, U13.2, U14.3, U15.3 (C), U16.2, U19.3 (C), U20.8 (GND), U21.2, U22.2, U23.2
unnamed: GND2.1, J1.4
unnamed: J0_1.1, U1.2, U2.2, U3.2, U4.2, U5.2, U6.2, U7.2, U8.2
unnamed: J0_1.2, R28.1
unnamed: J0_1.3, R29.1
unnamed: J0_2.1, R30.1
unnamed: J0_2.2, R31.1
unnamed: J0_2.3, R32.1
unnamed: J0_3.1, R33.1
unnamed: J0_3.2, R34.1
unnamed: J0_3.3, R27.1
unnamed: C6.1, J0_5.1, U9.3 (+)
unnamed: C5.1, J0_5.2, U10.3 (+)
unnamed: C4.1, J0_5.3, U11.3 (+)
unnamed: C3.1, J0_6.1, U12.3 (+)
unnamed: J0_7.1, Q5.1 (A1)
unnamed: J0_7.3, Q5.2 (A2), R13.2
unnamed: J0_8.1, R9.1
unnamed: J0_8.3, R10.1
unnamed: J0_9.1, U20.3 (OUT2)
unnamed: J0_9.3, U20.2 (OUT1)
unnamed: J0_10.1, U20.14 (OUT4)
unnamed: J0_10.3, U20.13 (OUT3)
unnamed: J0_13.1, R24.1, U18.6
unnamed: J0_13.3, R22.1, U17.6
unnamed: J0_14.1, Q7.2 (C)
unnamed: J0_14.3, PS3.4 (+Vout), PS4.3 (-Vout), Q7.3 (E)
unnamed: C11.2, J0_16.2, U20.4 (Vs)
unnamed: C10.2, J0_16.3, U20.9 (Vss)
unnamed: J0_18.1, Q6.2 (C)
unnamed: J0_18.3, PS1.3 (-Vout), PS2.4 (+Vout), Q6.3 (E)
unnamed: J0_19.1, K1.12
unnamed: J0_19.2, K1.14
unnamed: J0_19.3, K1.11
unnamed: J0_20.1, U16.4
unnamed: J0_21.1, K2.12
unnamed: J0_21.2, K2.14
unnamed: J0_21.3, K2.11
unnamed: J0_22.1, U21.4
unnamed: J0_23.1, K3.12
unnamed: J0_23.2, K3.14
unnamed: J0_23.3, K3.11
unnamed: J0_24.1, U22.4
unnamed: J0_25.1, K4.12
unnamed: J0_25.2, K4.14
unnamed: J0_25.3, K4.11
unnamed: J0_26.1, U23.4
unnamed: J1.5, RX1.1
unnamed: J1.6, TX1.1
unnamed: J1.7, RST1.1
unnamed: J1.8, P0.1
unnamed: J1.9, P22.1
unnamed: J1.10, P19.1
unnamed: J1.11, P23.1
unnamed: J1.12, P18.1
unnamed: J1.13, P5.1
unnamed: J1.14, P15.1
unnamed: J1.15, P2.1
unnamed: J1.16, P4.1
unnamed: J1.17, P17.1
unnamed: J1.18, P16.1
unnamed: J1.19, PX1.1
unnamed: J1.20, PX2.1
unnamed: J2.1, PX3.1
unnamed: J2.2, PX4.1
unnamed: J2.3, PX5.1
unnamed: J2.4, PX6.1
unnamed: J2.5, PX7.1
unnamed: J2.6, PX8.1
unnamed: J2.7, PX9.1
unnamed: J2.8, PX10.1
unnamed: J2.9, PX11.1
unnamed: J2.10, PX12.1
unnamed: J2.11, PX13.1
unnamed: J2.12, PX14.1
unnamed: J2.13, PX15.1
unnamed: J2.14, PX16.1
unnamed: J2.15, PX17.1
unnamed: J2.16, PX18.1
unnamed: J2.17, PX19.1
unnamed: J2.18, PX20.1
unnamed: J2.19, PX21.1
unnamed: J2.20, PX22.1
unnamed: J3.1, PX23.1
unnamed: J3.2, PX24.1
unnamed: J3.3, PX25.1
unnamed: J3.4, PX26.1
unnamed: J3.5, PX27.1
unnamed: J3.6, PX28.1
unnamed: J3.7, PX29.1
unnamed: J3.8, PX30.1
unnamed: J3.9, PX31.1
unnamed: J3.10, PX32.1
unnamed: J3.11, PX33.1
unnamed: J3.12, PX34.1
unnamed: J3.13, PX35.1
unnamed: J3.14, PX36.1
unnamed: J3.15, PX37.1
unnamed: J3.16, PX38.1
unnamed: J3.17, PX39.1
unnamed: J3.18, PX40.1
unnamed: J3.19, PX41.1
unnamed: J3.20, PX42.1
unnamed: J4.1, PX43.1
unnamed: J4.2, PX44.1
unnamed: J4.3, P21.1
unnamed: J4.4, P13.1
unnamed: J4.5, P12.1
unnamed: J4.6, P14.1
unnamed: J4.7, P27.1
unnamed: J4.8, P26.1
unnamed: J4.9, P25.1
unnamed: J4.10, P33.1
unnamed: J4.11, P32.1
unnamed: J4.12, P35.1
unnamed: J4.13, P34.1
unnamed: J4.14, P39.1
unnamed: J4.15, P38.1
unnamed: J4.16, P37.1
unnamed: J4.17, P36.1
unnamed: PS1.4 (+Vout), U15.8 (VCC)
unnamed: PS2.3 (-Vout), U15.5 (VEE)
unnamed: PS3.3 (-Vout), U19.5 (VEE)
unnamed: PS4.4 (+Vout), U19.8 (VCC)
unnamed: PS5.4 (+Vout), R12.1, R49.1
unnamed: PS6.4 (+Vout), U9.7 (V+), U10.7 (V+), U11.7 (V+), U12.7 (V+), U17.7 (V+), U18.7 (V+)
unnamed: PS7.3 (-Vout), U9.4 (V-), U10.4 (V-), U11.4 (V-), U12.4 (V-), U17.4 (V-), U18.4 (V-)
unnamed: PS8.4 (+Vout), Q1.3 (C), Q2.3 (C), Q3.3 (C), Q4.3 (C)
unnamed: PX45.1, U20.11 (EnB)
unnamed: PX46.1, R1.1, U1.3
unnamed: PX47.1, R2.1, U2.3
unnamed: PX48.1, R3.1, U3.3
unnamed: PX49.1, R4.1, U4.3
unnamed: PX50.1, R5.1, U5.3
unnamed: PX51.1, R6.1, U6.3
unnamed: PX52.1, R7.1, U7.3
unnamed: PX53.1, R8.1, U8.3
unnamed: PX54.1, R12.2, U14.4
unnamed: PX55.1, U20.6 (EnA)
unnamed: PX57.1, R18.1
unnamed: PX59.1, RV1.2
unnamed: PX62.1, U20.12 (IN4)
unnamed: PX63.1, R44.2
unnamed: PX66.1, R20.2
unnamed: PX67.1, R46.2
unnamed: PX69.1, R41.2
unnamed: PX72.1, R48.2
unnamed: PX80.1, R26.2
unnamed: PX111.1, U20.10 (IN3)
unnamed: PX112.1, U20.7 (IN2)
unnamed: PX113.1, U20.5 (IN1)
unnamed: C8.1, PX118.1, U17.3 (+)
unnamed: C9.1, PX119.1, U18.3 (+)
unnamed: PX121.1, Q4.1 (E), R35.1
unnamed: PX122.1, Q3.1 (E), R36.1
unnamed: PX123.1, Q2.1 (E), R37.1
unnamed: PX124.1, Q1.1 (E), R38.1
unnamed: Q1.2 (B), R14.1
unnamed: Q2.2 (B), R15.1
unnamed: Q3.2 (B), R16.1
unnamed: Q4.2 (B), R17.1
unnamed: Q5.3 (G), U13.4
unnamed: Q6.1 (G), R19.1
unnamed: Q7.1 (G), R25.1
unnamed: R11.2, U14.1
unnamed: R13.1, U13.6
unnamed: R18.2, U13.1
unnamed: R19.2, U15.7 (VO)
unnamed: R25.2, U19.7 (VO)
unnamed: R41.1, U16.1
unnamed: R44.1, U21.1
unnamed: R46.1, U22.1
unnamed: R48.1, U23.1
unnamed: R49.2, U1.4, U2.4, U3.4, U4.4, U5.4, U6.4, U7.4, U8.4
unnamed: R14.2, U9.2 (-), U9.6
unnamed: R15.2, U10.2 (-), U10.6
unnamed: R16.2, U11.2 (-), U11.6
unnamed: R17.2, U12.2 (-), U12.6
unnamed: R20.1, U15.2 (A)
unnamed: R21.1, R22.2, U17.2 (-)
unnamed: R23.1, R24.2, U18.2 (-)
unnamed: R26.1, U19.2 (A)
unnamed: R39.2, U20.1 (SENSE_A)
unnamed: R40.2, U20.15 (SENSE_B)

Notes on the sheet:
Otro ESP32 u otros modulos
ESP32

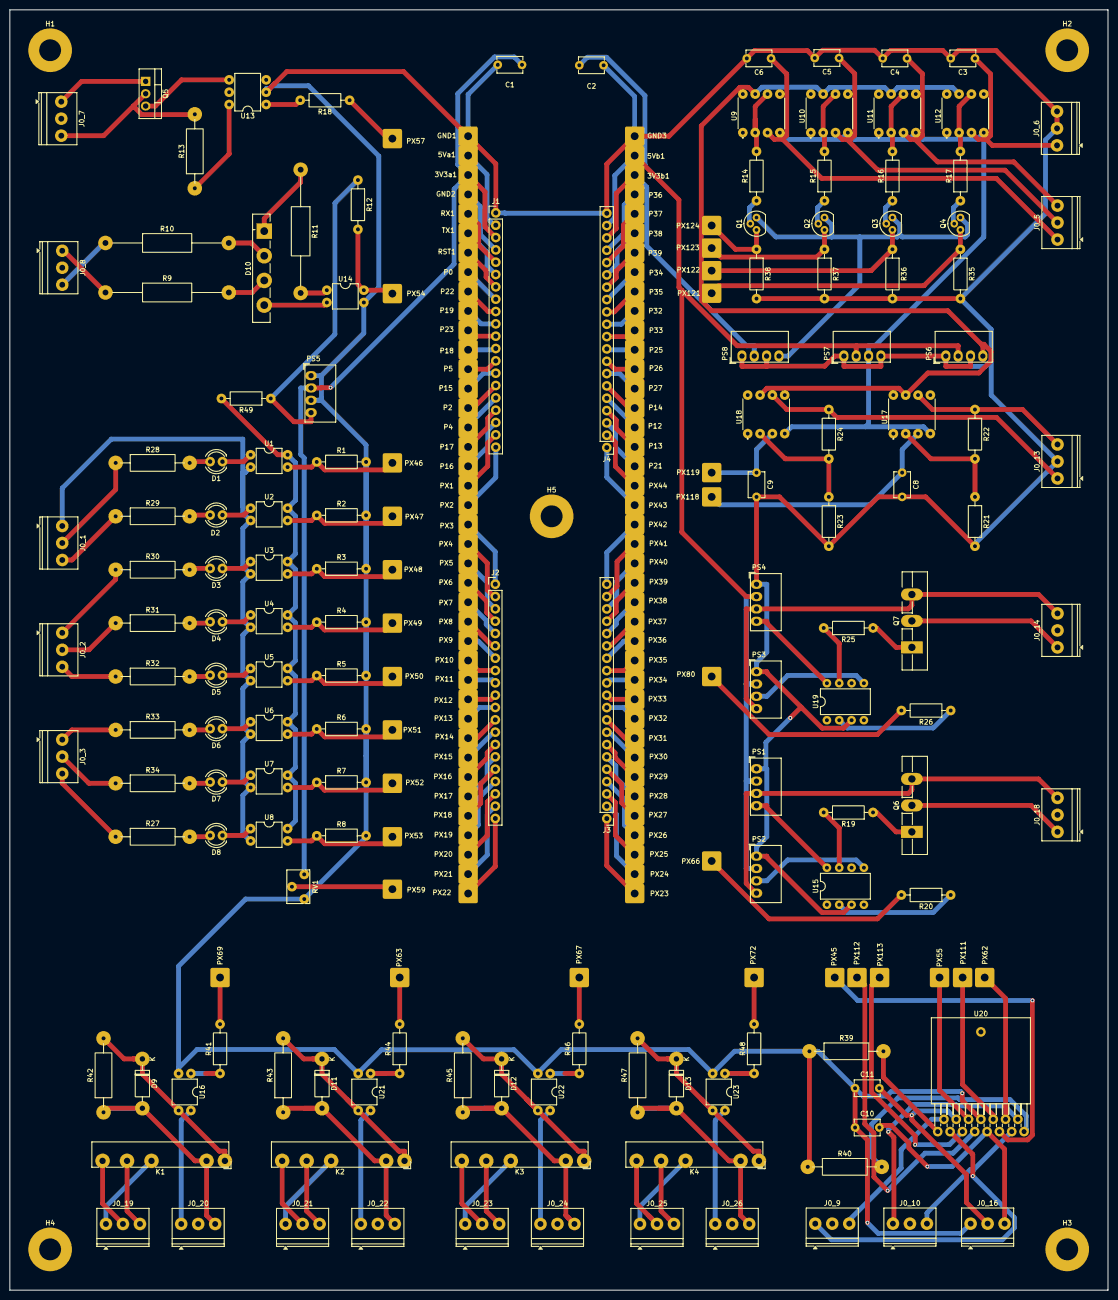
[picture p55: board PCB_HORNO.kicad_pcb from above]

Board: 2 copper layers, 226.2 x 263.7 mm, 254 parts (0 on the bottom side), 216 nets.

Other parts of the board:
H1, H2, H3, H4, H5: MountingHole_4.5mm_Pad
