Bojtronic/TFG/Hardware/esp32/interfaz_esp32/interfaz_esp32.kicad_pcb

## KiCad design Hardware/esp32/interfaz_esp32/interfaz_esp32.kicad_pcb (2025-10-12)

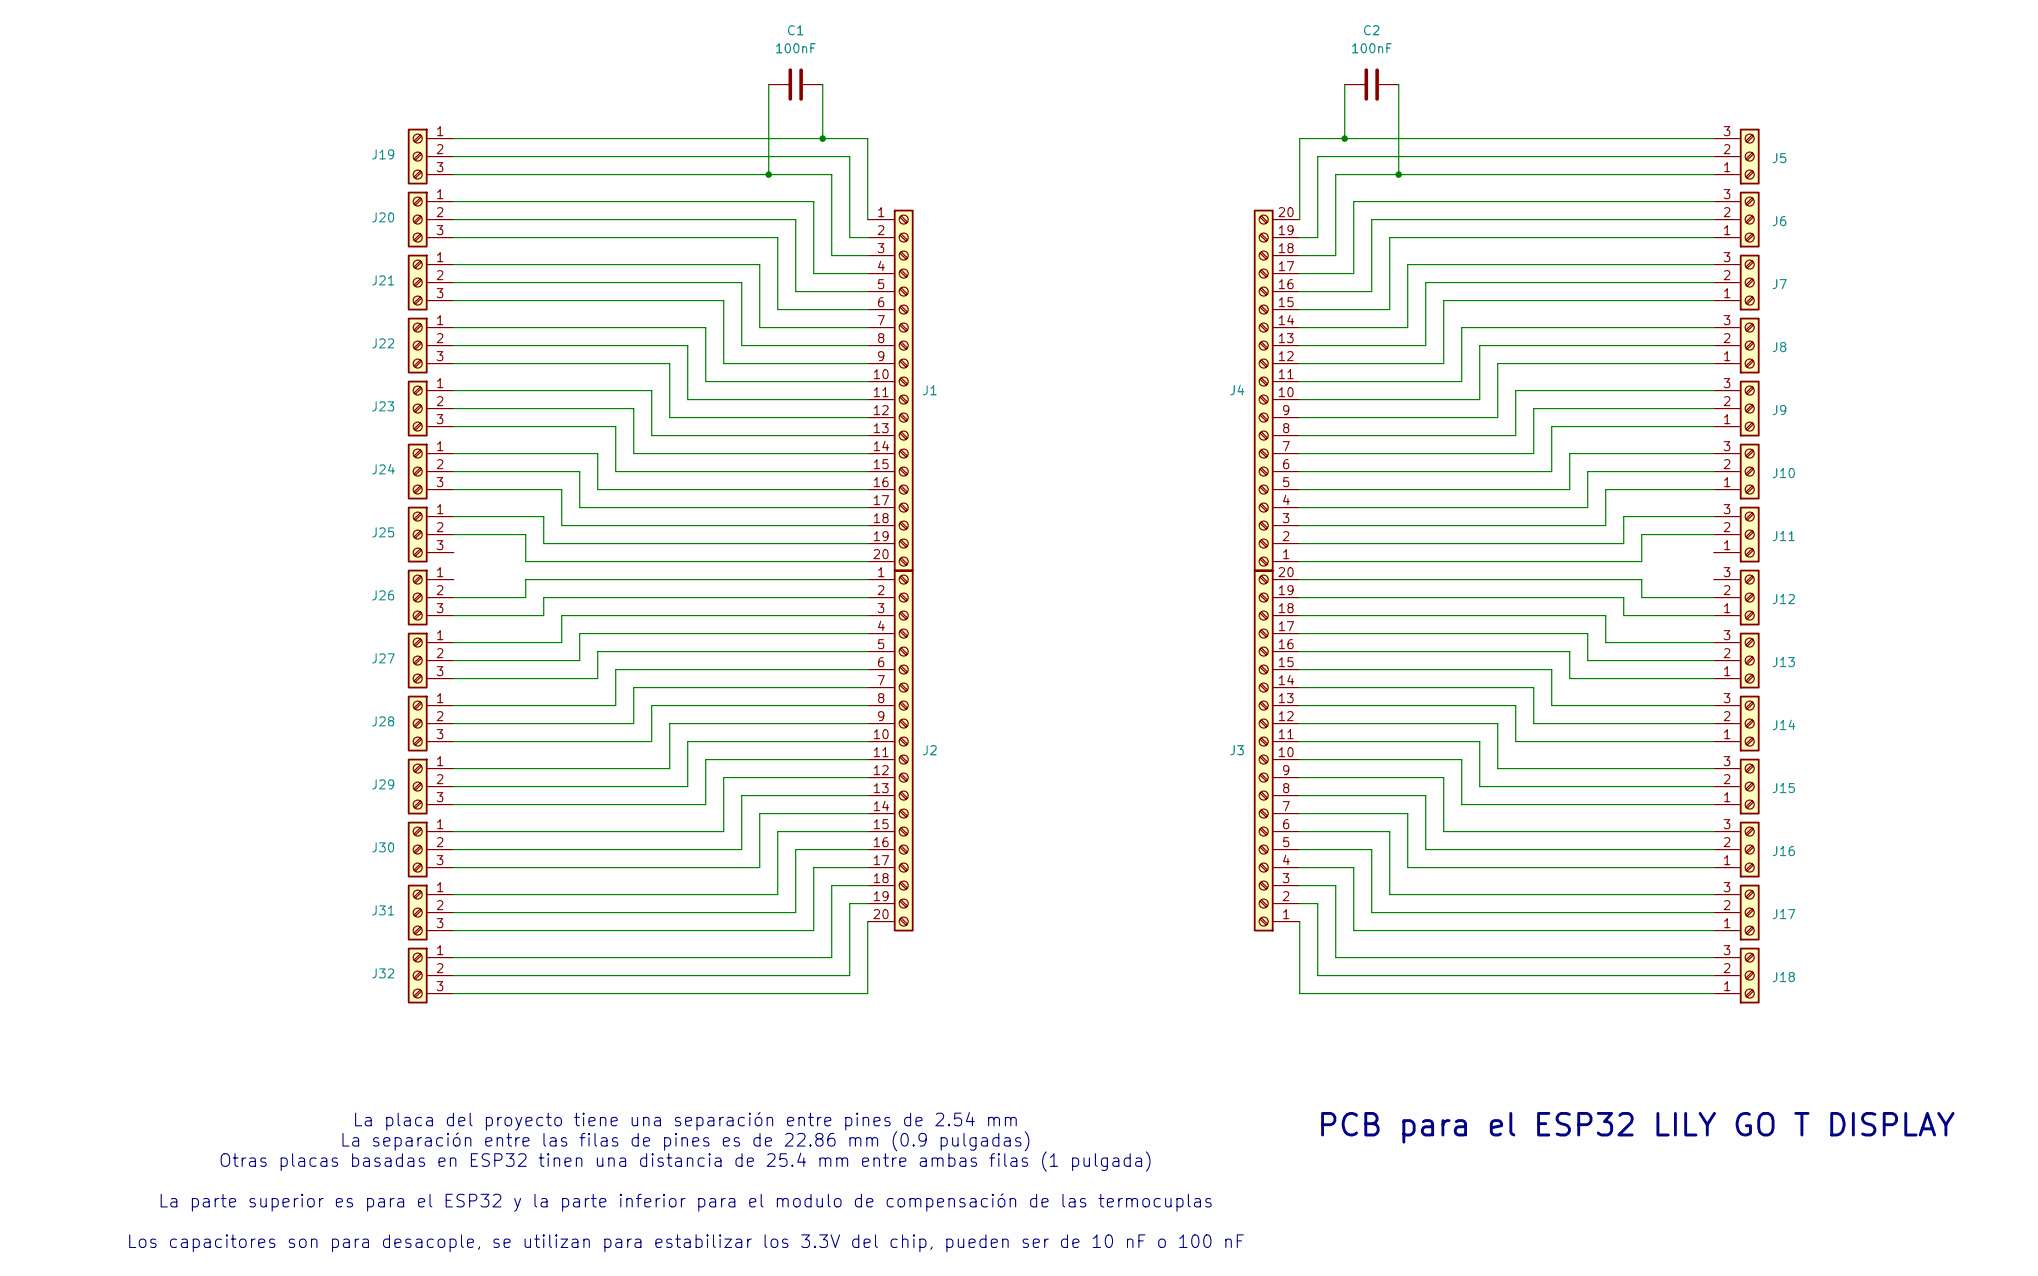
[picture p56: schematic interfaz_esp32.kicad_sch, PCB para el ESP32 LILY GO T DISPLAY]

Parts:
C1, C2: 100nF; C_Disc_D4.3mm_W1.9mm_P5.00mm
J1, J2, J3, J4: Screw_Terminal_01x20; PinHeader_1x20_P2.54mm_Vertical
J5, J6, J7, J8, J9, J10, J11, J12, J13, J14, J15, J16, J17, J18, J19, J20, J21, J22, J23, J24, J25, J26, J27, J28, J29, J30, J31, J32: Screw_Terminal_01x03; TerminalBlock_Phoenix_PT-1,5-3-3.5-H_1x03_P3.50mm_Horizontal

Connections:
unnamed: C1.1, J1.1, J19.1
unnamed: J1.2, J19.2
unnamed: C1.2, J1.3, J19.3
unnamed: J1.4, J20.1
unnamed: J1.5, J20.2
unnamed: J1.6, J20.3
unnamed: J1.7, J21.1
unnamed: J1.8, J21.2
unnamed: J1.9, J21.3
unnamed: J1.10, J22.1
unnamed: J1.11, J22.2
unnamed: J1.12, J22.3
unnamed: J1.13, J23.1
unnamed: J1.14, J23.2
unnamed: J1.15, J23.3
unnamed: J1.16, J24.1
unnamed: J1.17, J24.2
unnamed: J1.18, J24.3
unnamed: J1.19, J25.1
unnamed: J1.20, J25.2
unnamed: J2.1, J26.2
unnamed: J2.2, J26.3
unnamed: J2.3, J27.1
unnamed: J2.4, J27.2
unnamed: J2.5, J27.3
unnamed: J2.6, J28.1
unnamed: J2.7, J28.2
unnamed: J2.8, J28.3
unnamed: J2.9, J29.1
unnamed: J2.10, J29.2
unnamed: J2.11, J29.3
unnamed: J2.12, J30.1
unnamed: J2.13, J30.2
unnamed: J2.14, J30.3
unnamed: J2.15, J31.1
unnamed: J2.16, J31.2
unnamed: J2.17, J31.3
unnamed: J2.18, J32.1
unnamed: J2.19, J32.2
unnamed: J2.20, J32.3
unnamed: J4.6, J9.1
unnamed: J4.7, J9.2
unnamed: J4.8, J9.3
unnamed: J4.9, J8.1
unnamed: J4.10, J8.2
unnamed: J4.11, J8.3
unnamed: J4.12, J7.1
unnamed: J4.13, J7.2
unnamed: J4.14, J7.3
unnamed: J4.15, J6.1
unnamed: J4.16, J6.2
unnamed: J4.17, J6.3
unnamed: C2.1, J4.18, J5.1
unnamed: J4.19, J5.2
unnamed: C2.2, J4.20, J5.3
unnamed: J4.3, J10.1
unnamed: J4.4, J10.2
unnamed: J4.5, J10.3
unnamed: J4.1, J11.2
unnamed: J4.2, J11.3
unnamed: J3.19, J12.1
unnamed: J3.20, J12.2
unnamed: J3.16, J13.1
unnamed: J3.17, J13.2
unnamed: J3.18, J13.3
unnamed: J3.13, J14.1
unnamed: J3.14, J14.2
unnamed: J3.15, J14.3
unnamed: J3.10, J15.1
unnamed: J3.11, J15.2
unnamed: J3.12, J15.3
unnamed: J3.7, J16.1
unnamed: J3.8, J16.2
unnamed: J3.9, J16.3
unnamed: J3.4, J17.1
unnamed: J3.5, J17.2
unnamed: J3.6, J17.3
unnamed: J3.1, J18.1
unnamed: J3.2, J18.2
unnamed: J3.3, J18.3

Notes on the sheet:
PCB para el ESP32 LILY GO T DISPLAY
La placa del proyecto tiene una separación entre pines de 2.54 mm La separación entre las filas de pines es de 22.86 mm (0.9 pulgadas) Otras placas basadas en ESP32 tinen una distancia de 25.4 mm entre ambas filas (1 pulgada) La parte superior es para el ESP32 y la parte inferior para el modulo de 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
