Bojtronic/TFG/Hardware/esp32/interfaz_esp32/interfaz_esp32.kicad_pcb

## KiCad design Hardware/esp32/interfaz_esp32/interfaz_esp32.kicad_pcb (continued)

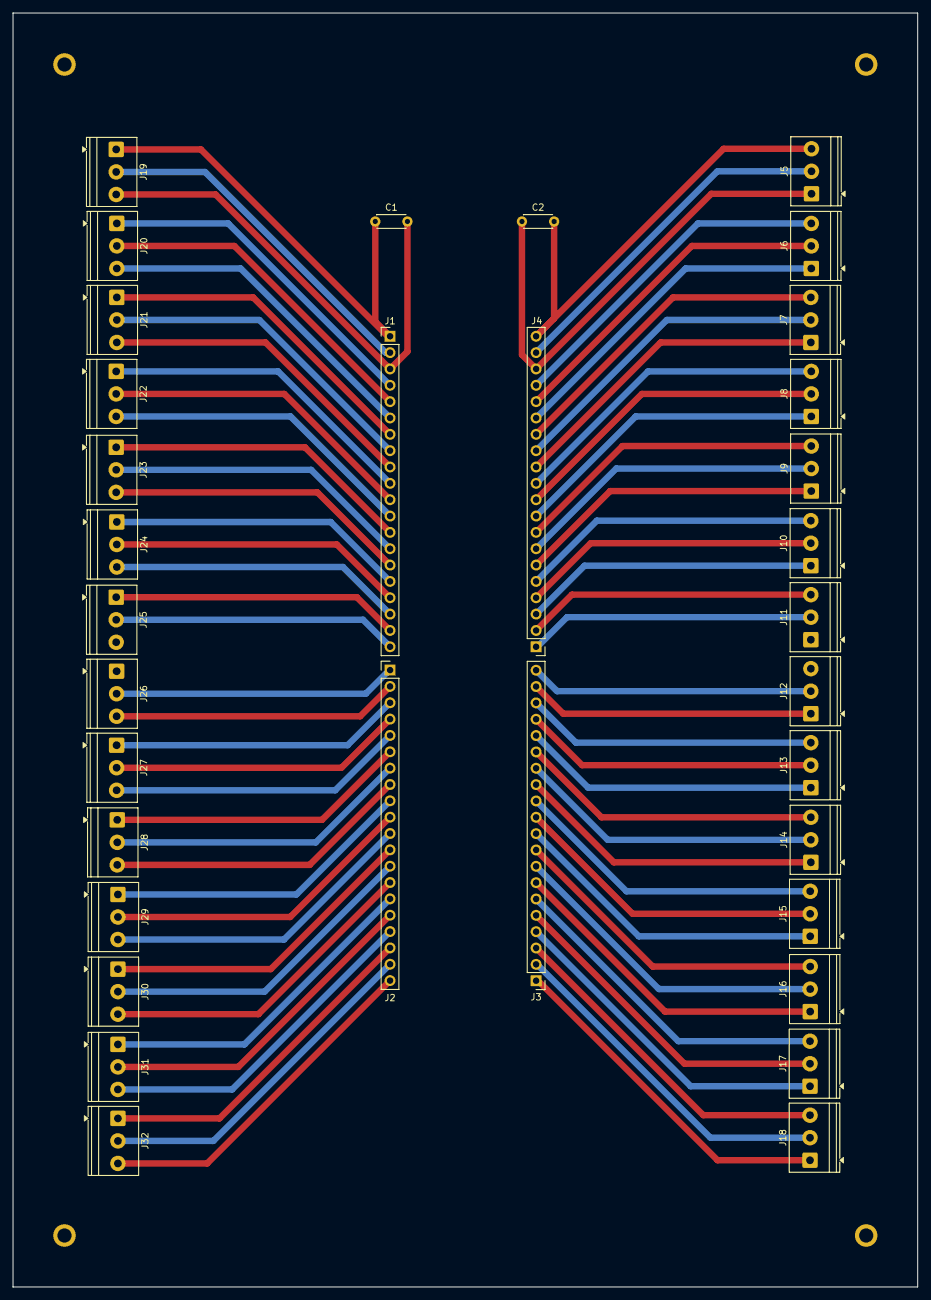
[picture p57: board interfaz_esp32.kicad_pcb from above]

Board: 2 copper layers, 140.6 x 198.0 mm, 34 parts (0 on the bottom side), 80 nets.
