Bojtronic/TFG/Hardware/Digitales/Interfaz_digital/Interfaz_digital.kicad_pcb

## KiCad design Hardware/Digitales/Interfaz_digital/Interfaz_digital.kicad_pcb (2025-10-12)

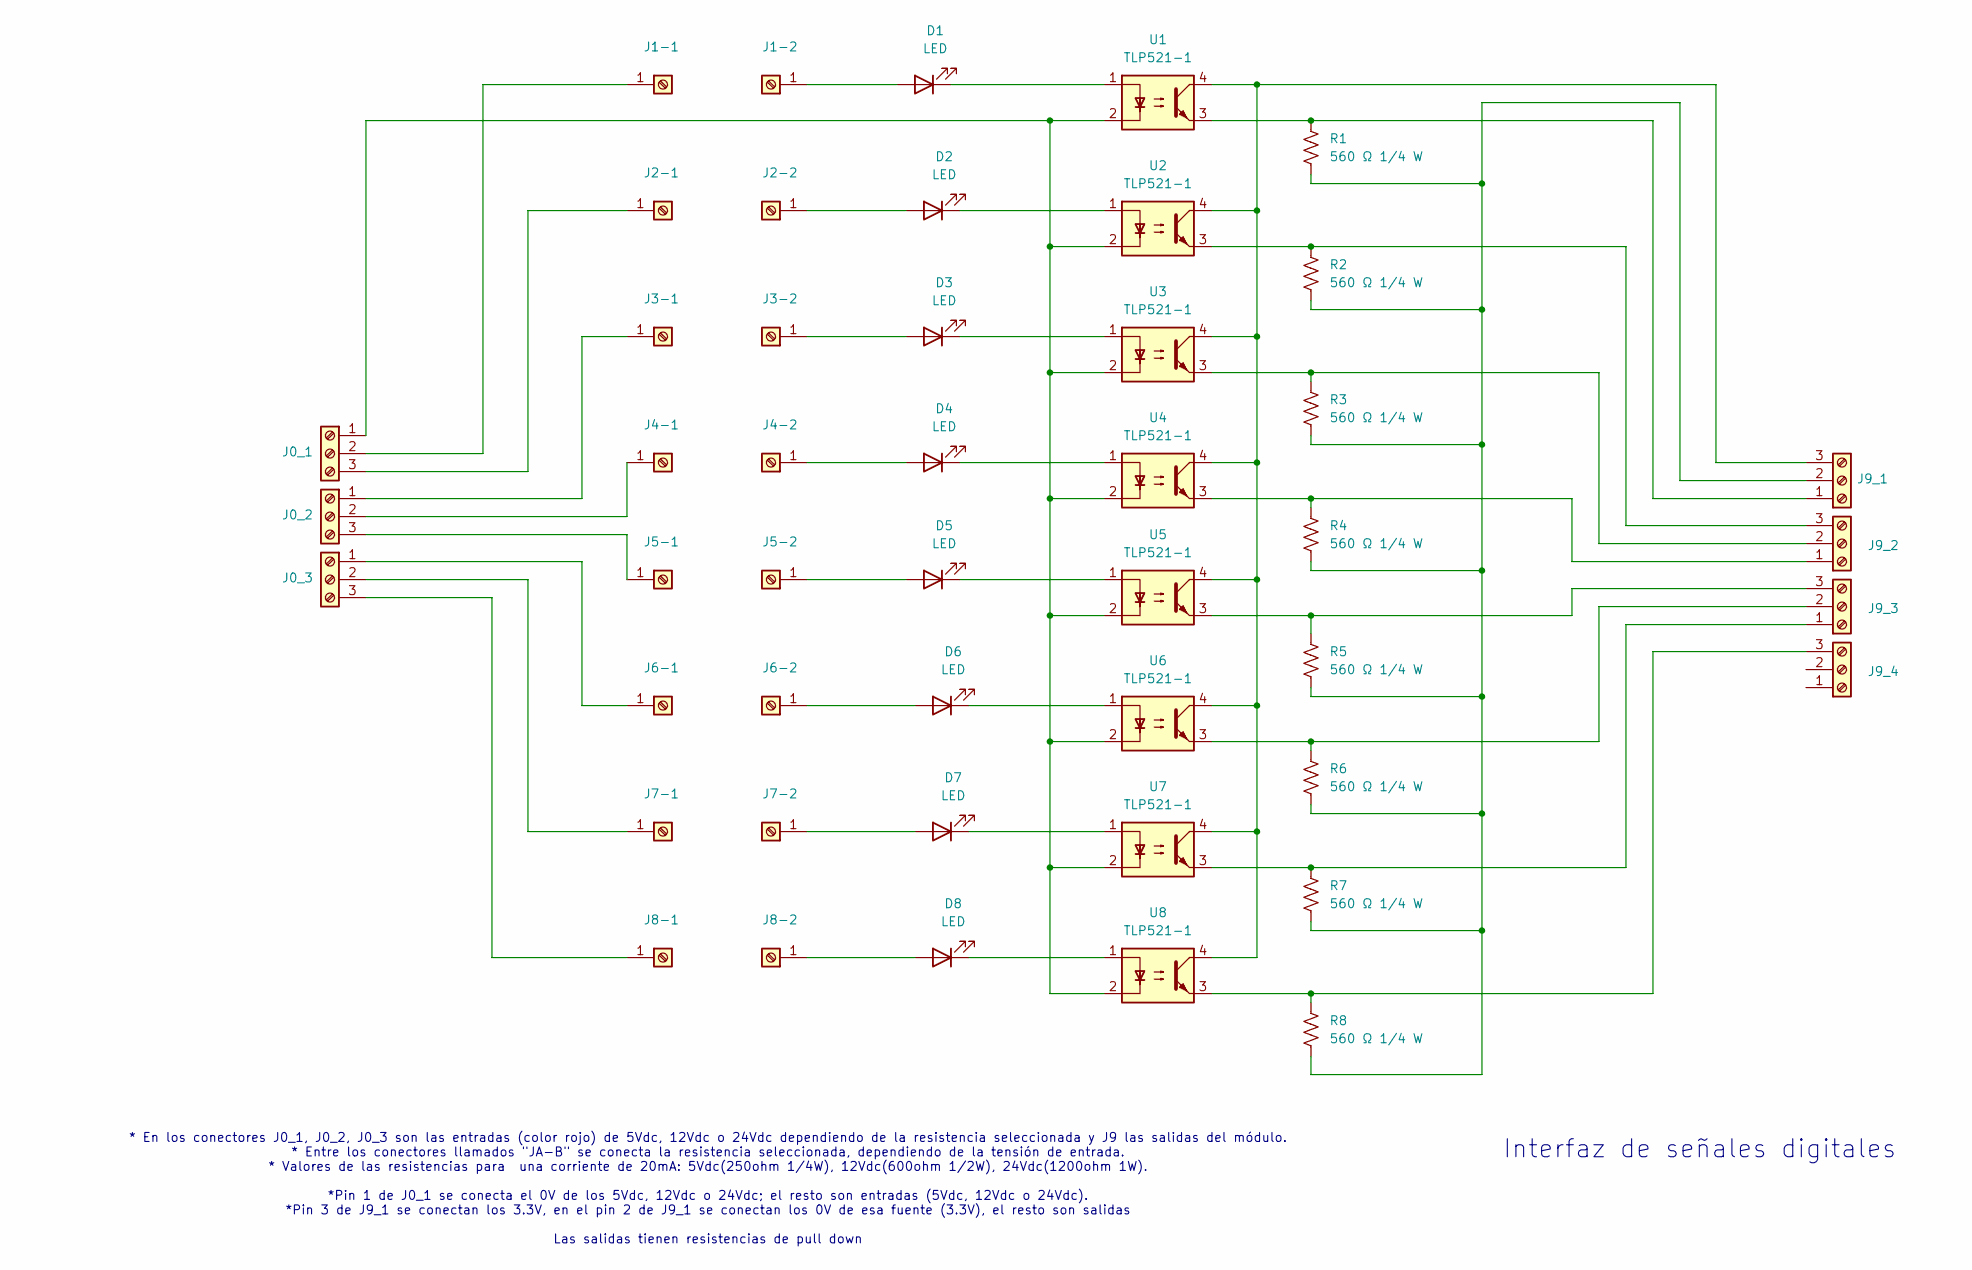
[picture p58: schematic Interfaz_digital.kicad_sch, Interfaz de señales digitales]

Parts:
D1, D2, D3, D4, D5, D6, D7, D8: LED; LED_D4.0mm
J0_1, J0_2, J0_3, J9_1, J9_2, J9_3, J9_4: Screw_Terminal_01x03; TerminalBlock_Phoenix_PT-1,5-3-3.5-H_1x03_P3.50mm_Horizontal
J1-1, J1-2, J2-1, J2-2, J3-1, J3-2, J4-1, J4-2, J5-1, J5-2, J6-1, J6-2, J7-1, J7-2, J8-1, J8-2: Screw_Terminal_01x01; TerminalBlock_MetzConnect_360271_1x01_Horizontal_ScrewM3.0_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
R1, R2, R3, R4, R5, R6, R7, R8: 560 Ω 1/4 W; R_Axial_DIN0207_L6.3mm_D2.5mm_P10.16mm_Horizontal
U1, U2, U3, U4, U5, U6, U7, U8: TLP521-1; DIP-4_W7.62mm

Connections:
unnamed: D1.2 (A), J1-2.1
unnamed: D1.1 (K), U1.1
unnamed: D2.2 (A), J2-2.1
unnamed: D2.1 (K), U2.1
unnamed: D3.2 (A), J3-2.1
unnamed: D3.1 (K), U3.1
unnamed: D4.2 (A), J4-2.1
unnamed: D4.1 (K), U4.1
unnamed: D5.2 (A), J5-2.1
unnamed: D5.1 (K), U5.1
unnamed: D6.2 (A), J6-2.1
unnamed: D6.1 (K), U6.1
unnamed: D7.2 (A), J7-2.1
unnamed: D7.1 (K), U7.1
unnamed: D8.2 (A), J8-2.1
unnamed: D8.1 (K), U8.1
unnamed: J0_1.1, U1.2, U2.2, U3.2, U4.2, U5.2, U6.2, U7.2, U8.2
unnamed: J0_1.2, J1-1.1
unnamed: J0_1.3, J2-1.1
unnamed: J0_2.1, J3-1.1
unnamed: J0_2.2, J4-1.1
unnamed: J0_2.3, J5-1.1
unnamed: J0_3.1, J6-1.1
unnamed: J0_3.2, J7-1.1
unnamed: J0_3.3, J8-1.1
unnamed: J9_1.1, R1.1, U1.3
unnamed: J9_1.2, R1.2, R2.2, R3.2, R4.2, R5.2, R6.2, R7.2, R8.2
unnamed: J9_1.3, U1.4, U2.4, U3.4, U4.4, U5.4, U6.4, U7.4, U8.4
unnamed: J9_2.1, R4.1, U4.3
unnamed: J9_2.2, R3.1, U3.3
unnamed: J9_2.3, R2.1, U2.3
unnamed: J9_3.1, R7.1, U7.3
unnamed: J9_3.2, R6.1, U6.3
unnamed: J9_3.3, R5.1, U5.3
unnamed: J9_4.3, R8.1, U8.3

Notes on the sheet:
Interfaz de señales digitales
* En los conectores J0_1, J0_2, J0_3 son las entradas (color rojo) de 5Vdc, 12Vdc o 24Vdc dependiendo de la resistencia seleccionada y J9 las salidas del módulo. * Entre los conectores llamados "JA-B" se conecta la resistencia seleccionada, dependiendo de la tensión de entrada. * Valores de las res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

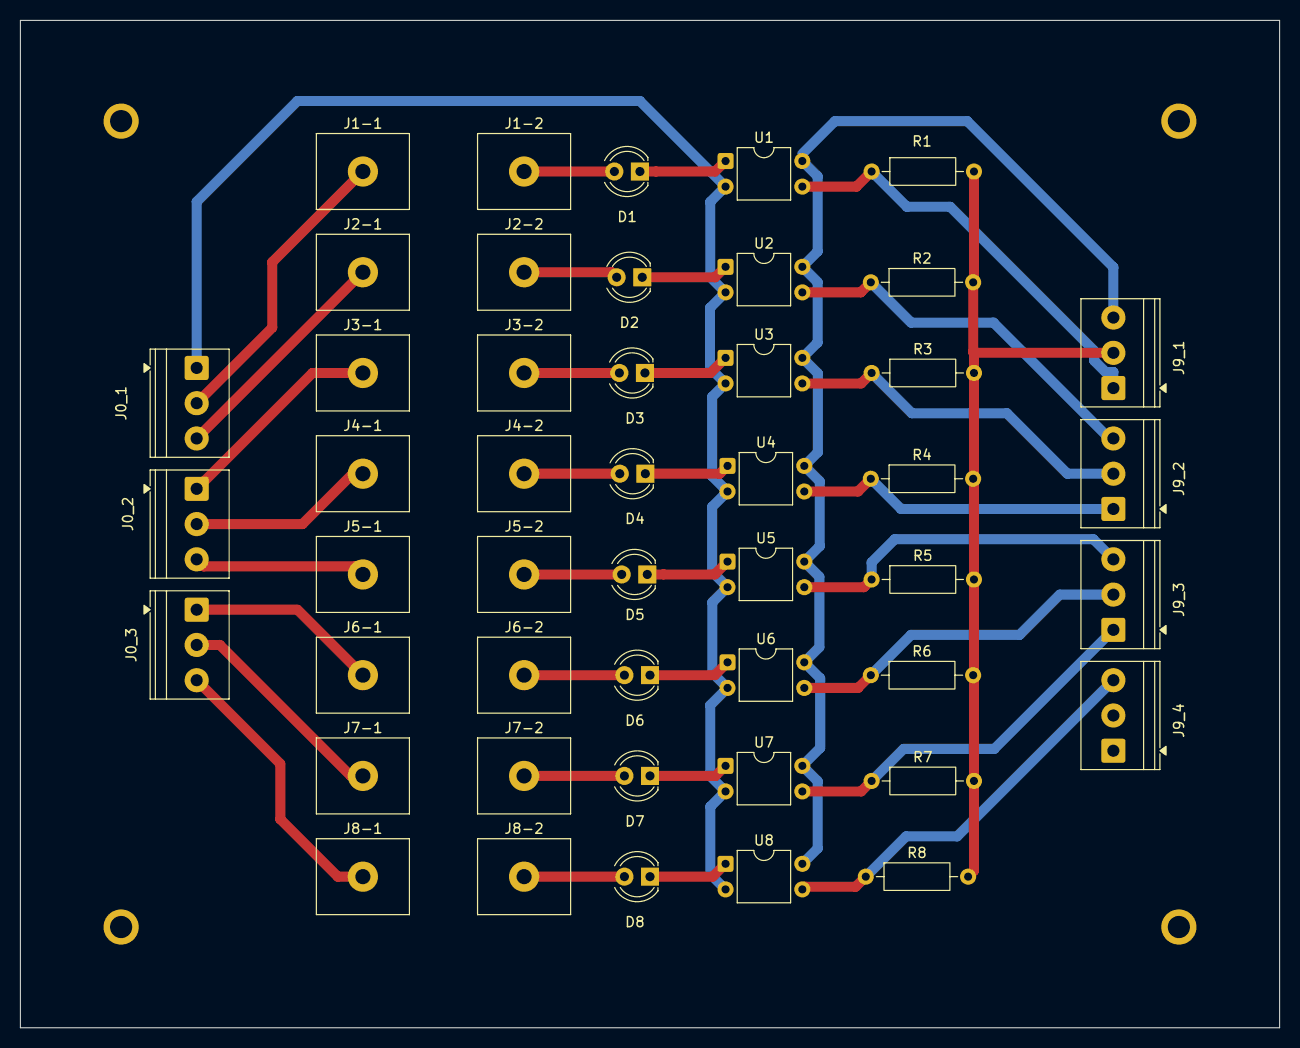
[picture p59: board Interfaz_digital.kicad_pcb from above]

Board: 2 copper layers, 125.0 x 100.0 mm, 47 parts (0 on the bottom side), 35 nets.
