Bojtronic/TFG/Hardware/Analogicas/Interfaz_analogica/Interfaz_analogica.kicad_pcb

## KiCad design Hardware/Analogicas/Interfaz_analogica/Interfaz_analogica.kicad_pcb (2025-10-12)

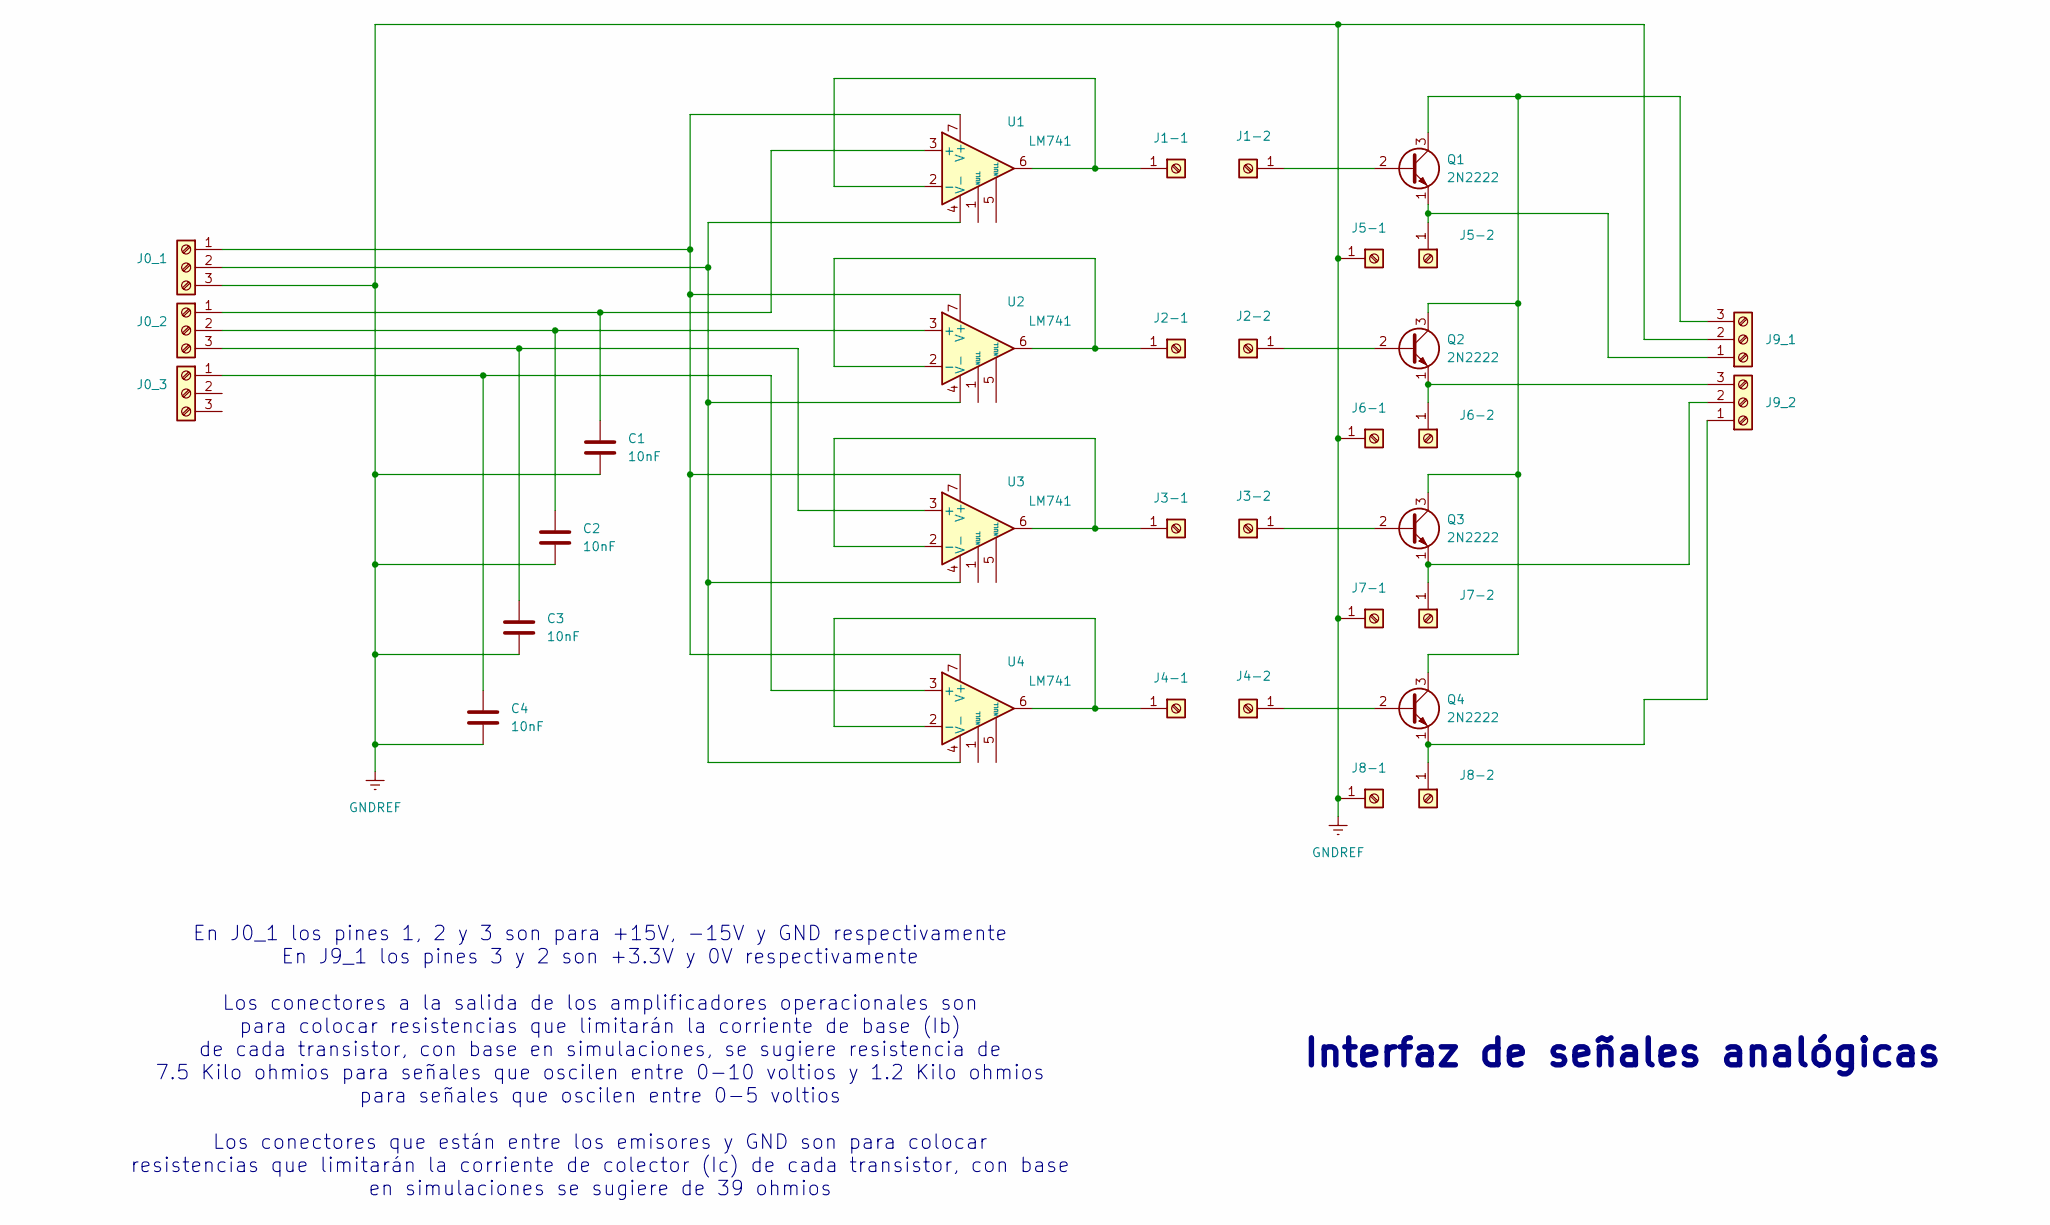
[picture p60: schematic Interfaz_analogica.kicad_sch, Interfaz analógica]

Parts:
C1, C2, C3, C4: 10nF; C_Disc_D4.3mm_W1.9mm_P5.00mm
J0_1, J0_2, J0_3, J9_1, J9_2: Screw_Terminal_01x03; TerminalBlock_Phoenix_PT-1,5-3-3.5-H_1x03_P3.50mm_Horizontal
J1-1, J1-2, J2-1, J2-2, J3-1, J3-2, J4-1, J4-2, J5-1, J5-2, J6-1, J6-2, J7-1, J7-2, J8-1, J8-2: Screw_Terminal_01x01; TerminalBlock_MetzConnect_360271_1x01_Horizontal_ScrewM3.0_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
Q1, Q2, Q3, Q4: 2N2222; TO-39-3
U1, U2, U3, U4: LM741; LM741_TH

Connections:
GNDREF: C1.2, C2.2, C3.2, C4.2, J0_1.3, J5-1.1, J6-1.1, J7-1.1, J8-1.1, J9_1.2
unnamed: J0_1.1, U1.7 (V+), U2.7 (V+), U3.7 (V+), U4.7 (V+)
unnamed: J0_1.2, U1.4 (V-), U2.4 (V-), U3.4 (V-), U4.4 (V-)
unnamed: C1.1, J0_2.1, U1.3 (+)
unnamed: C2.1, J0_2.2, U2.3 (+)
unnamed: C3.1, J0_2.3, U3.3 (+)
unnamed: C4.1, J0_3.1, U4.3 (+)
unnamed: J1-1.1, U1.2 (-), U1.6
unnamed: J1-2.1, Q1.2 (B)
unnamed: J2-1.1, U2.2 (-), U2.6
unnamed: J2-2.1, Q2.2 (B)
unnamed: J3-1.1, U3.2 (-), U3.6
unnamed: J3-2.1, Q3.2 (B)
unnamed: J4-1.1, U4.2 (-), U4.6
unnamed: J4-2.1, Q4.2 (B)
unnamed: J5-2.1, J9_1.1, Q1.1 (E)
unnamed: J6-2.1, J9_2.3, Q2.1 (E)
unnamed: J7-2.1, J9_2.2, Q3.1 (E)
unnamed: J8-2.1, J9_2.1, Q4.1 (E)
unnamed: J9_1.3, Q1.3 (C), Q2.3 (C), Q3.3 (C), Q4.3 (C)

Notes on the sheet:
En J0_1 los pines 1, 2 y 3 son para +15V, -15V y GND respectivamente En J9_1 los pines 3 y 2 son +3.3V y 0V respectivamente Los conectores a la salida de los amplificadores operacionales son para colocar resistencias que limitarán la corriente de base (Ib) de cada transistor, con base en simulacion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
Interfaz de señales analógicas

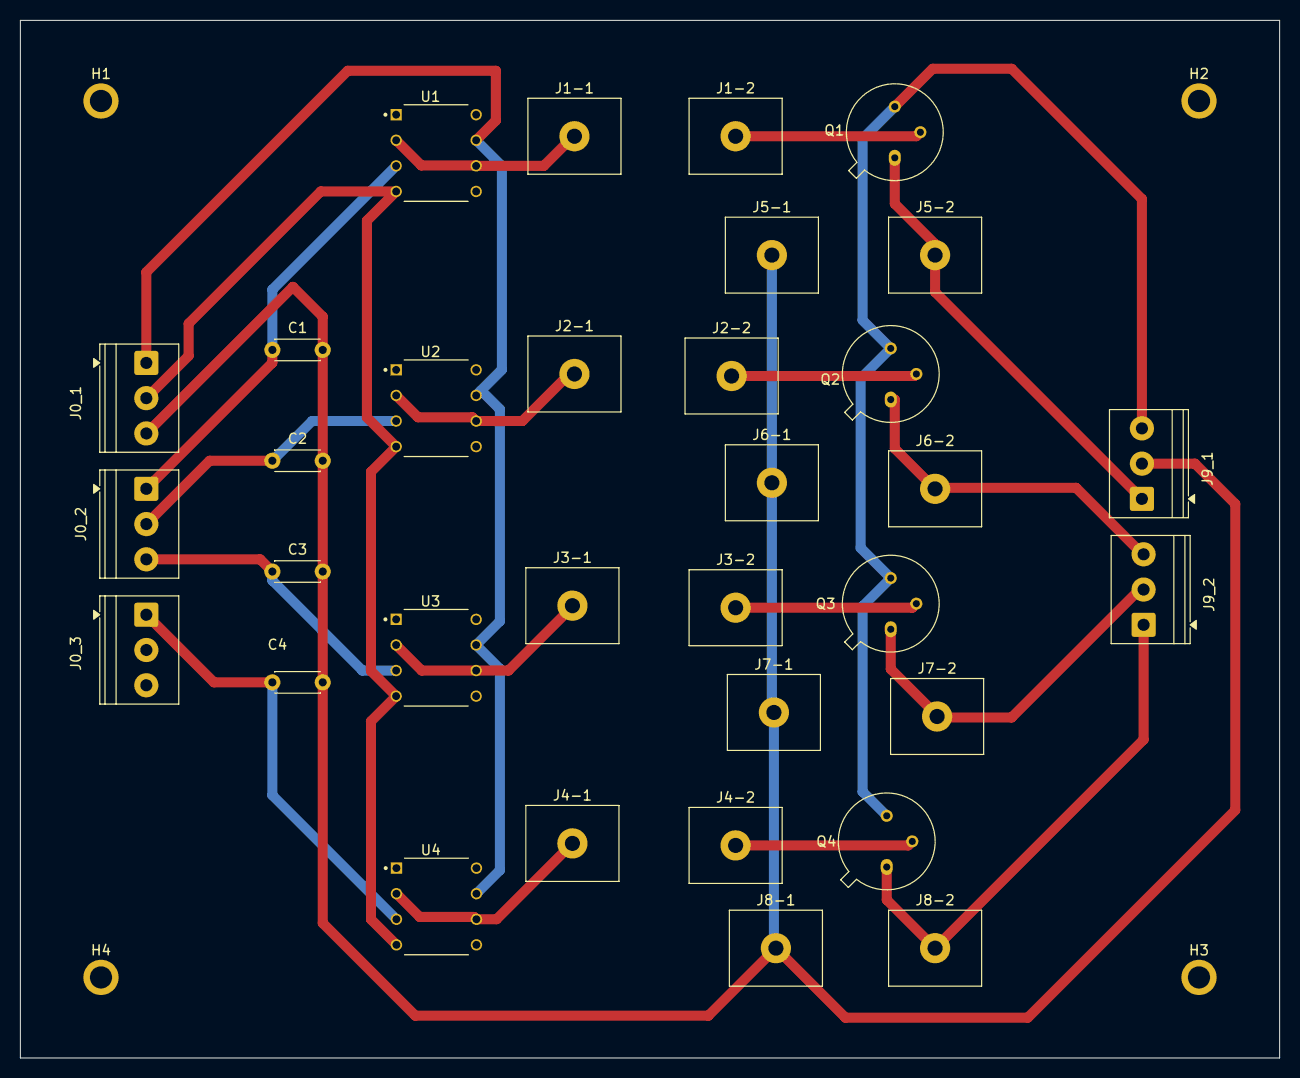
[picture p61: board Interfaz_analogica.kicad_pcb from above]

Board: 2 copper layers, 125.0 x 103.0 mm, 37 parts (0 on the bottom side), 20 nets.

Other parts of the board:
H1, H2, H3, H4: MountingHole_2.2mm_M2_ISO7380_Pad
