Bojtronic/TFG/Horno_esp32/control.h

#ifndef CONTROL_H
#define CONTROL_H

void controlarSistema();
void iniciarSistema();
bool verificarCondicionesInicio();
void detenerSistema();
void activarCirculacion();
void alternarBombas();
void manual();
bool verificarCondicionesApagado();

#endif
