Bojtronic/TFG/Horno_esp32/sensores.h

#ifndef SENSORES_H
#define SENSORES_H

#include <Adafruit_MAX31855.h>

void leerSensores();
void inicializarTermocuplas();
bool verificarSensoresTemperatura();
void leerTemperaturas();
double leerTermocupla(Adafruit_MAX31855 &sensor, int numero);
void leerPresion();
void leerNiveles();
void leerPulsadores();

#endif
