Bojtronic/TFG/(commit log)

2025-08-05 Ejemplos de ESP32 y creacion de la interfaz para el dashboard del horno
2025-08-09 Comunicacion entre Interfaz y ESP32 mediante el broker de EMQX (MQTT y Angular 17)
2025-08-09 Configuracion para hacer deploy en la nube (host render)
2025-08-09 Correccion para el deploy en la nube
2025-08-09 Instalación de http-server
2025-08-09 Ajuste de seguridad para el deploy en la nube
2025-08-10 Creacion de servidor usando express (node js) con la intencion de habilitar la comunicacion en render
2025-08-10 Agregando dependencias que faltaban
2025-08-11 Modificacón de la función doPublish() y cambios en la interfaz grafica
2025-08-11 Modificación de la función doPublish()
2025-08-11 Cambio de unsafePublish a publish
2025-08-11 Cambiando de nuevo de Publish() a unsafePublish()
2025-08-13 Codigo base para el horno de secado de transformadores
2025-08-19 Datos de arduino cloud
    [interfaces [20241104, 16-54-21].pdsprj, interfaces [20241104, 17-07-36].pdsprj, interfaces [20241104, 17-07-44].pdsprj, interfaces [20241104, 17-08-11].pdsprj, interfaces [20241104, 17-11-20].pdsprj, interfaces [20241104, 17-11-33].pdsprj, interfaces [20241104, 17-13-09].pdsprj, interfaces [20241104, 17-13-11].pdsprj]
2025-08-19 Configuracion para arduino cloud (en proceso)
2025-08-25 Ejemplo funcional de ESP32 con Arduino cloud
2025-08-26 Configuracion para Arduino Cloud (Se debe utilizar el servicio de API KEY el cual es de pago)
2025-08-29 Codigo de referencia
2025-09-05 Primera propuesta de codigo para el ESP32 (verificar compilacion y tamaño)
2025-09-08 Corrección de errores al codigo del esp32
    [Horno_esp32.ino, comunicacion.cpp, config.cpp, config.h, hmi.cpp, hmi.h, sensores.cpp]
2025-09-08 Quitar el EMO del sistema
2025-09-08 Optimizando codigo del esp32
2025-09-10 Inicio de los diagramas para las interfaces hardware
    [Interfaz_analogica.kicad_pcb, Interfaz_analogica.kicad_sch, Interfaz_digital.kicad_pcb, Interfaz_digital.kicad_sch]
2025-09-12 Codigo para las termocuplas
2025-09-13 Creación del servidor y el cliente (control) con node js
2025-09-13 Actualización de servidor y clliente, incluye prueba de comunicacion desde el esp32
2025-09-13 Link del servidor en la nube
2025-09-14 Corrección de la función sendCommand()
2025-09-14 Simulación de transmision de datos entre el servidor y el ESP32
2025-09-15 Interfaz analógica
    [Interfaz_analogica.kicad_sch]
2025-09-15 Referencias a los componentes de los circuitos
    [Interfaz_analogica.kicad_sch, Interfaz_digital.kicad_sch]
2025-09-16 Footprint para el LM741
    [Interfaz_analogica.kicad_sch]
2025-09-16 Primera versión de la PCB para la interfaz analógica
    [Interfaz_analogica.kicad_pcb, Interfaz_analogica.kicad_sch]
2025-09-17 Lectura de la temperatura en la aplicación web
2025-09-17 Lectura de presión en la aplicación web
2025-09-17 Actualización del codigo del ESP32
    [Interfaz_analogica.kicad_pcb, Interfaz_analogica.kicad_sch]
2025-09-20 Conexion del harware para los sensores y los actuadores
    Inicio de la maquina de estados finitos
2025-09-20 FSM terminada pero falta verificar el funcionamiento
2025-09-23 Actualización de interfaz y comandos enviados
2025-09-23 Actualización de interfaz
2025-09-23 Archivos para pruebas
2025-09-24 Pruebas mejoradas con varios casos para cada estado
2025-09-24 Pruebas exitosas para los cambios de estado usando la aplicación web y los pulsadores, simulando los datos de los sensores para inducir estados funcionales (PROCESANDO, DETENER y MANUAL
2025-09-24 Comunicación con la aplicación web: se envian o se reciben datos cada 3 segundos
2025-09-25 Mensajes de estado
2025-09-25 Debug para el codigo de mensaje
2025-09-25 Mejorando estilo de advertencia grave
2025-09-25 Mejorando estilo de emergencia grave
2025-09-26 Habilitar los switches para los actuadores unicamente para el estado MANUAL
2025-09-26 Mejora visual para los switches en el estado MANUAL y demas estados
2025-09-26 Estilo para la advertencia de switches en estado MANUAL
2025-09-26 Advertencia de switches en estado MANUAL
2025-09-26 Estilos para los botones de estados
2025-09-26 Mejorar para el envio de comandos en estado MANUAL
2025-09-26 Mejoras para el envio de comandos en estado MANUAL
2025-09-27 Información sobre la activacion/desactivacion de actuadores
2025-09-30 Corrección para el mensaje de alerta en estado manual
2025-09-30 Trabajando en el PCB de señales digitales
    [Interfaz_digital.kicad_pcb, Interfaz_digital.kicad_sch, freerouting.dsn, temp-freerouting.dsn]
2025-10-01 Creación de PCB's con los archivos gerber y drill
    [Interfaz_analogica-B_Cu.gbr, Interfaz_analogica-B_Mask.gbr, Interfaz_analogica-B_Paste.gbr, Interfaz_analogica-B_Silkscreen.gbr, Interfaz_analogica-Edge_Cuts.gbr, Interfaz_analogica-F_Cu.gbr, Interfaz_analogica-F_Mask.gbr, Interfaz_analogica-F_Paste.gbr]
2025-10-01 Actualización de la lectura para los sensores de nivel de agua en el tanque
2025-10-01 Eliminación de codigo innecesario
2025-10-02 PCB para el ESP32
    [interfaz_esp32-B_Cu.gbr, interfaz_esp32-B_Mask.gbr, interfaz_esp32-B_Paste.gbr, interfaz_esp32-B_Silkscreen.gbr, interfaz_esp32-Edge_Cuts.gbr, interfaz_esp32-F_Cu.gbr, interfaz_esp32-F_Mask.gbr, interfaz_esp32-F_Paste.gbr]
2025-10-02 Pruebas con archivo de simulación y lectura de sensores
2025-10-03 Capacitores de desacople
    [interfaz_esp32.kicad_pcb, interfaz_esp32.kicad_sch]
2025-10-03 Interfaz de la HMI
2025-10-03 Trabajando en la HMI
2025-10-04 HMI lista para pruebas
2025-10-04 Esquematicos de las PCB
    [Interfaz_analogica.kicad_sch, Interfaz_digital.kicad_sch, interfaz_esp32.kicad_sch]
2025-10-07 Recursos para la documentación
2025-10-07 Visualización de datos en HMI
2025-10-07 Gestion de la comunicación UART del HMI
2025-10-08 Mejoras en la comunicación del HMI
2025-10-08 Imagen de la interfaz del HMI
2025-10-08 Se crean variables que almacenan valores anteriores para optimizar la comunicación
2025-10-08 Optimización de la función checkForCommands()
2025-10-08 Optimización de la función connectToWiFi()
2025-10-08 Ajustes en la comunicación
2025-10-09 Pruebas al prototipo con todo integrado BOD (los sensores de presion y nivel se simularon con fuentes)
2025-10-11 Imagenes para la documentación
2025-10-12 Agregando agujeros para montaje a las PCB
    [Interfaz_analogica.kicad_pcb, Interfaz_digital.kicad_pcb, interfaz_esp32.kicad_pcb]
2025-10-12 Ruteo de la interfaz analógica
    [Interfaz_analogica.kicad_pcb]
2025-10-13 Eliminación de archivos innecesarios
    [interfaces [20241104, 16-54-21].pdsprj, interfaces [20241104, 17-07-36].pdsprj, interfaces [20241104, 17-07-44].pdsprj, interfaces [20241104, 17-08-11].pdsprj, interfaces [20241104, 17-11-20].pdsprj, interfaces [20241104, 17-11-33].pdsprj, interfaces [20241104, 17-13-09].pdsprj, interfaces [20241104, 17-13-11].pdsprj]
2025-10-13 Comentando codigo para debug (Serial.print())
2025-10-14 Iniciando una PCB que integre todos los modulos
    [PCB_HORNO.kicad_pcb, PCB_HORNO.kicad_sch]
2025-10-14 Integrando todas las interfaces
    [PCB_HORNO.kicad_pcb, PCB_HORNO.kicad_sch]
2025-10-14 Reorganizando elementos
    [PCB_HORNO.kicad_pcb, PCB_HORNO.kicad_sch]
2025-10-15 Integración de nuevos modulos al PCB (puente H, detector de cruce por cero, disparo con triac, salida analogica amplificada)
    [PCB_HORNO.kicad_sch]
2025-10-16 Corrección de funciones de verificarSeguridad y detenerSistema
2025-10-16 Integrando nuevos modulos al PCB
    [PCB_HORNO.kicad_sch]
2025-10-17 Actualización de PCB
    [PCB_HORNO.kicad_pcb, PCB_HORNO.kicad_sch]
2025-10-17 Versión preliminar del PCB
    [PCB_HORNO.kicad_sch]
2025-10-17 Esquematico listo
    [PCB_HORNO.kicad_pcb, PCB_HORNO.kicad_sch]
2025-10-18 Reorganización del esquematico
    [PCB_HORNO.kicad_pcb, PCB_HORNO.kicad_sch]
2025-10-18 Organizando elementos en PCB
    [PCB_HORNO.kicad_pcb, PCB_HORNO.kicad_sch]
2025-10-19 Actualización de esquematico
    [PCB_HORNO.kicad_pcb, PCB_HORNO.kicad_sch]
2025-10-20 Agregando diodos de rueda libre (flyback)
    [PCB_HORNO.kicad_pcb, PCB_HORNO.kicad_sch]
2025-10-20 PCB preliminar
    [PCB_HORNO.kicad_pcb]
2025-10-20 Esquematico definitivo
    [PCB_HORNO.kicad_pcb, PCB_HORNO.kicad_sch]
2025-10-21 Layout del PCB
    [PCB_HORNO.kicad_pcb]
2025-10-22 Ruteo de PCB
    [PCB_HORNO.kicad_pcb, PCB_HORNO.kicad_sch]
2025-10-22 Archivos de fabricación .gerber y .drl
    [PCB_HORNO-B_Cu.gbr, PCB_HORNO-B_Mask.gbr, PCB_HORNO-B_Paste.gbr, PCB_HORNO-B_Silkscreen.gbr, PCB_HORNO-Edge_Cuts.gbr, PCB_HORNO-F_Cu.gbr, PCB_HORNO-F_Mask.gbr, PCB_HORNO-F_Paste.gbr]
2025-10-22 Archivos para fabricación .gbr y .drl
    [PCB_HORNO-B_Cu.gbr, PCB_HORNO-B_Mask.gbr, PCB_HORNO-B_Paste.gbr, PCB_HORNO-B_Silkscreen.gbr, PCB_HORNO-Edge_Cuts.gbr, PCB_HORNO-F_Cu.gbr, PCB_HORNO-F_Mask.gbr, PCB_HORNO-F_Paste.gbr]
